jsc69/ComponentTester/doku/pcb.bmp

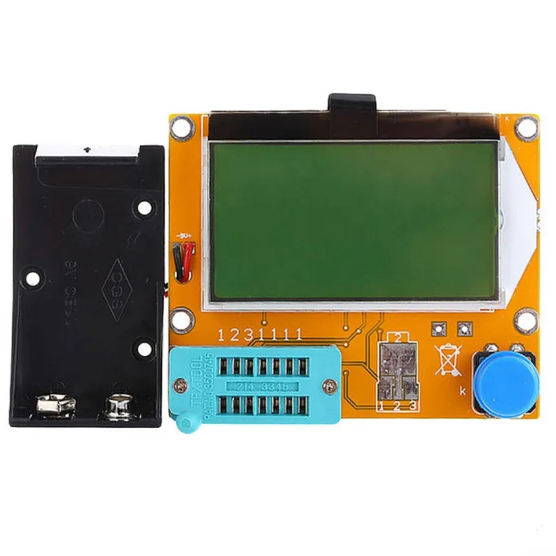
doku/pcb.bmp
