jsc69/ComponentTester/software/ArduTester/README.md

# Ardutester
ArduTester – Arduino Component Tester

This is an Arduino porting of the excellent work by Markus Frejek.</br>
The Ardutester software is based on porting by Markus Reschke (madires@theca-tabellaria.de)

The final aim is to create an economic component tester using Arduino and a few passive components; 
I’m trying to make the system more scalable as possible, so you can view the output in Serial Terminal or alternatively via a I2C LCD.</br>
I’m working on a shield which will also include the components for the Logic Analyzer (Another project of ABC). For my convenience i publish first SMD version and then TH Version.

This is the basic design:



## Fork
https://github.com/kr4fty/ArduProj
