jsc69/ComponentTester/software/brutzelboy_demo.gif

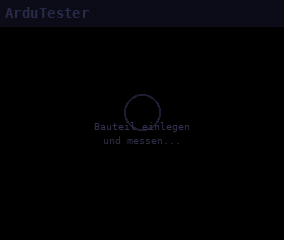
software/brutzelboy_demo.gif
