jsc69/ComponentTester/3d/stencil-ComponentTester.FCStd

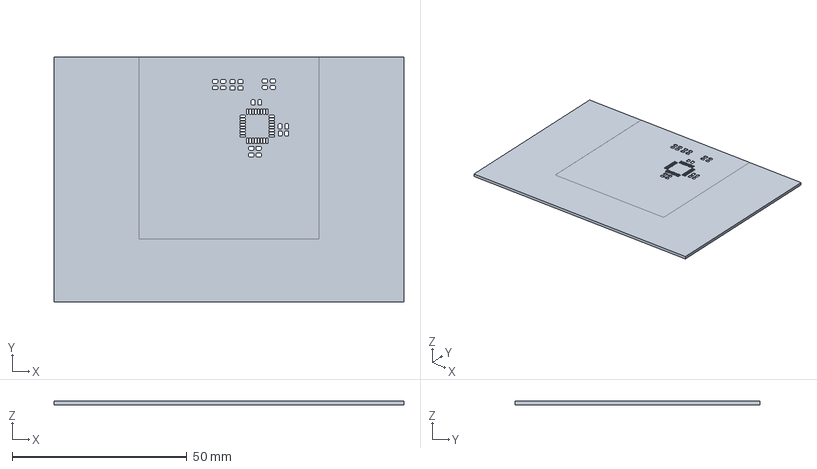
[picture p92: CAD file, 2025-10-31]
3d/stencil-ComponentTester.FCStd
100.0 x 70.0 x 1.05 mm
