jsc69/ComponentTester/3d/stencil.FCStd

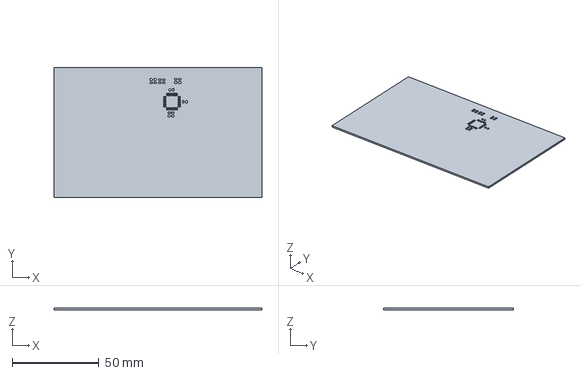
[picture p93: CAD file, 2025-10-31]
3d/stencil.FCStd
120.0 x 75.0 x 1.00 mm
