jsc69/ComponentTester/3d/cartridge.FCStd

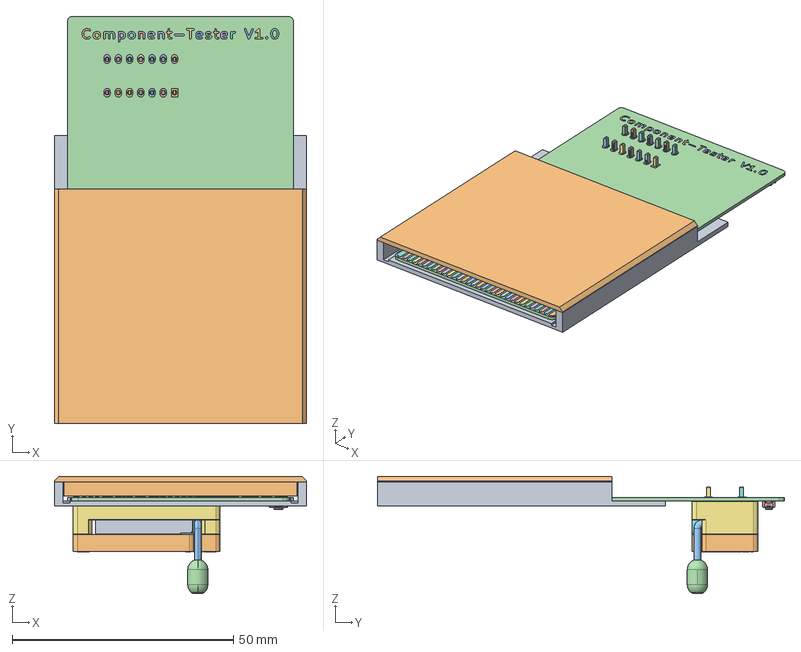
[picture p94: CAD file, 2025-10-31]
3d/cartridge.FCStd
57.0 x 91.9 x 26.4 mm
back001
front
R_0805_2012Metric
R_0805_2012Metric001
R_0805_2012Metric002
R_0805_2012Metric003
C_0805_2012Metric
TQFP-32_7x7mm_P0.8mm
R_0805_2012Metric004
R_0805_2012Metric005
R_0805_2012Metric006
C_0805_2012Metric001
C_0805_2012Metric002
C_0805_2012Metric003
01 Zif Socket Body_1
02 Zif Socket Body_2
02 Zif Socket Body_003
03 Zif Socket Body_3
04 Zif Socket Handle
04 Zif Socket Handle001
06 Zif Socket Screw
06 Zif Socket Screw001
05 Zif Socket Pin
05 Zif Socket Pin001
05 Zif Socket Pin002
05 Zif Socket Pin003
05 Zif Socket Pin004
05 Zif Socket Pin005
05 Zif Socket Pin006
05 Zif Socket Pin007
05 Zif Socket Pin008
05 Zif Socket Pin009
05 Zif Socket Pin010
05 Zif Socket Pin011
05 Zif Socket Pin012
05 Zif Socket Pin013
SW_Push_1P1T_NO_CK_KMR2
ComponentTester_pad
ComponentTester_pad001
ComponentTester_pad002
ComponentTester_pad003
ComponentTester_pad004
ComponentTester_pad005
ComponentTester_pad006
ComponentTester_pad007
ComponentTester_pad008
ComponentTester_pad009
ComponentTester_pad010
ComponentTester_pad011
ComponentTester_pad012
ComponentTester_pad013
ComponentTester_pad014
ComponentTester_pad015
ComponentTester_pad016
ComponentTester_pad017
ComponentTester_pad018
ComponentTester_pad019
ComponentTester_pad020
ComponentTester_pad021
ComponentTester_pad022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
