jsc69/ComponentTester/3d/stencil-CompomentTester.stl

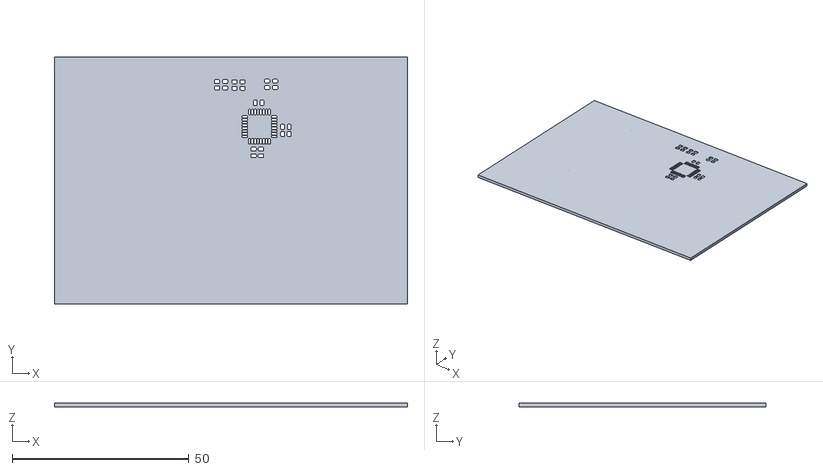
[picture p95: CAD file, 2025-10-31]
3d/stencil-CompomentTester.stl
100.0 x 70.0 x 1.05
