jsc69/ComponentTester/3d/cartridge-front.step

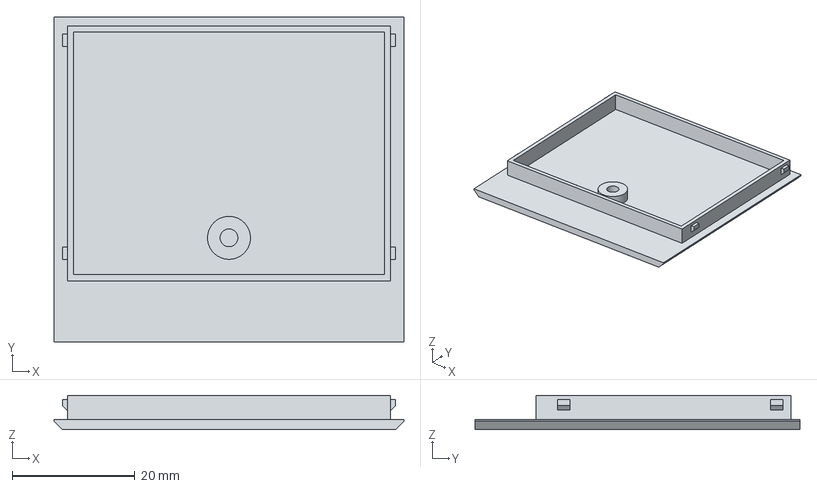
[picture p96: CAD file, 2025-09-19]
3d/cartridge-front.step
57.0 x 53.0 x 5.60 mm
