jsc69/ComponentTester/3d/cartridge-back.step

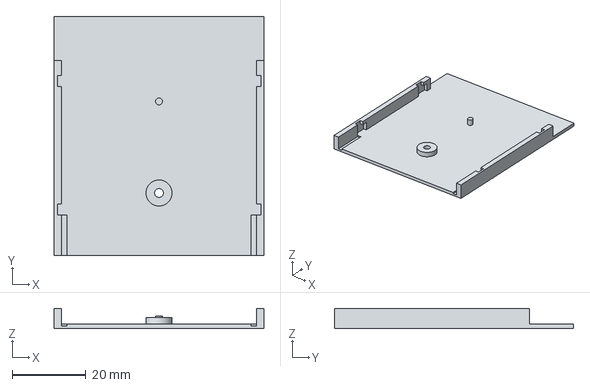
[picture p97: CAD file, 2025-09-19]
3d/cartridge-back.step
57.0 x 65.0 x 5.50 mm
