jsc69/ComponentTester/doku/tester_uno_tim1.bmp

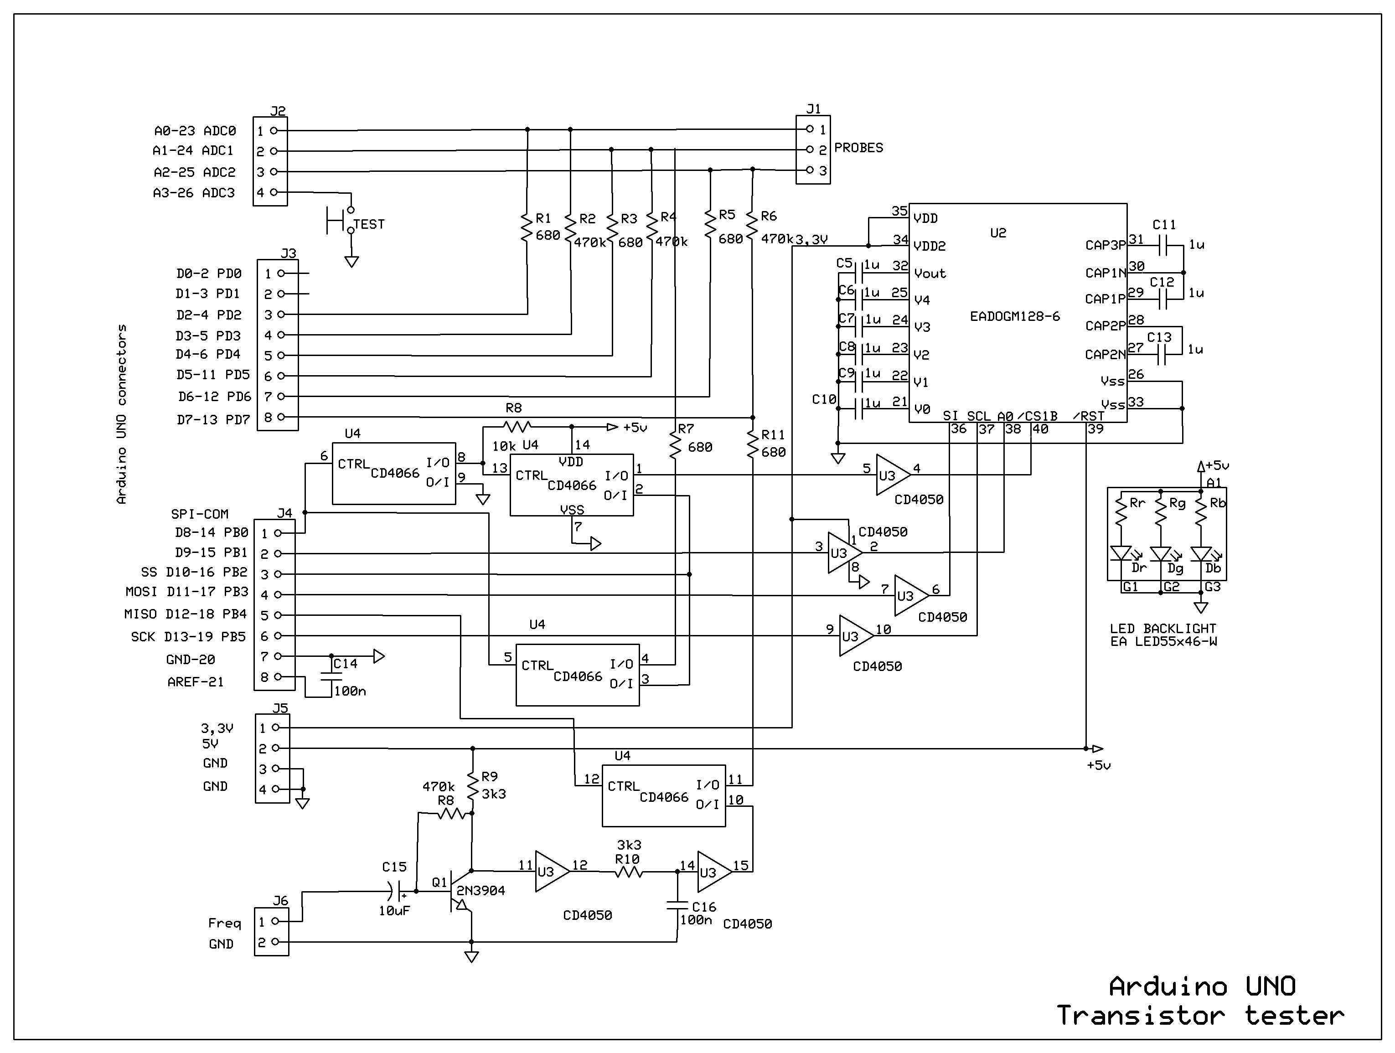
doku/tester_uno_tim1.bmp
