jsc69/ComponentTester/hardware/ComponentTester/ComponentTester.pdf

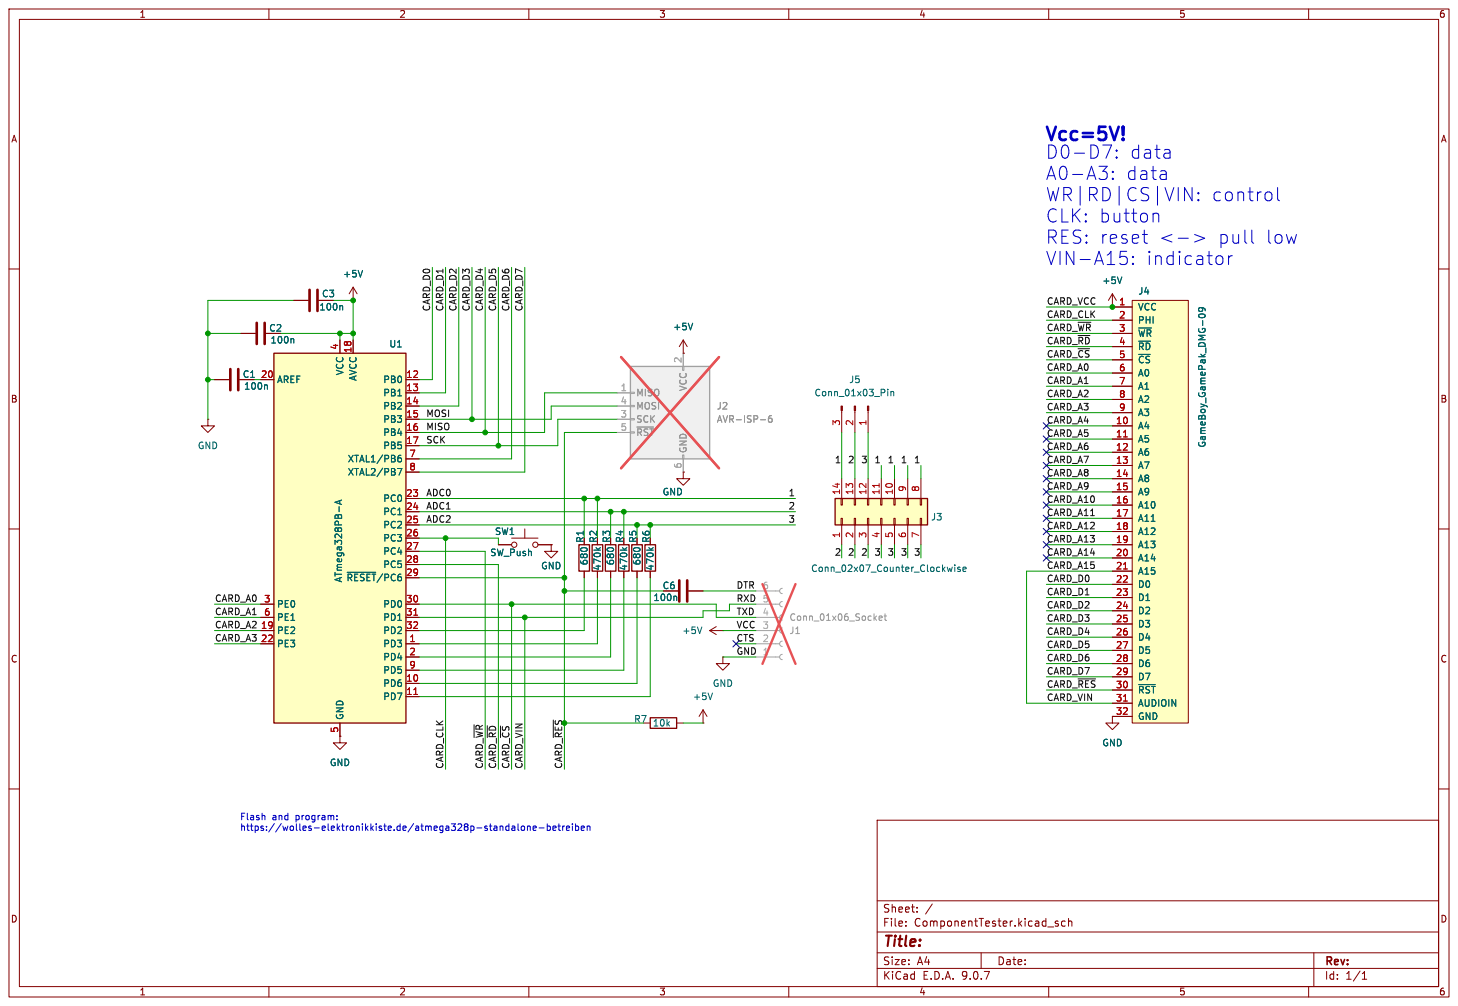
[picture p100: page 1]

6 MISO 1 MOSI 4 SCK 3 ~{RST} 5 +5V GND R3 680 R4 470k R2 470k R5 680 R1 680 R6 470k C6

6 MISO 1 MOSI 4 SCK 3 ~{RST} 5

Flash and program: https://wolles-elektronikkiste.de/atmega328p-standalone-betreiben GND
