jsc69/ComponentTester/doku/GBC_CARD.pdf

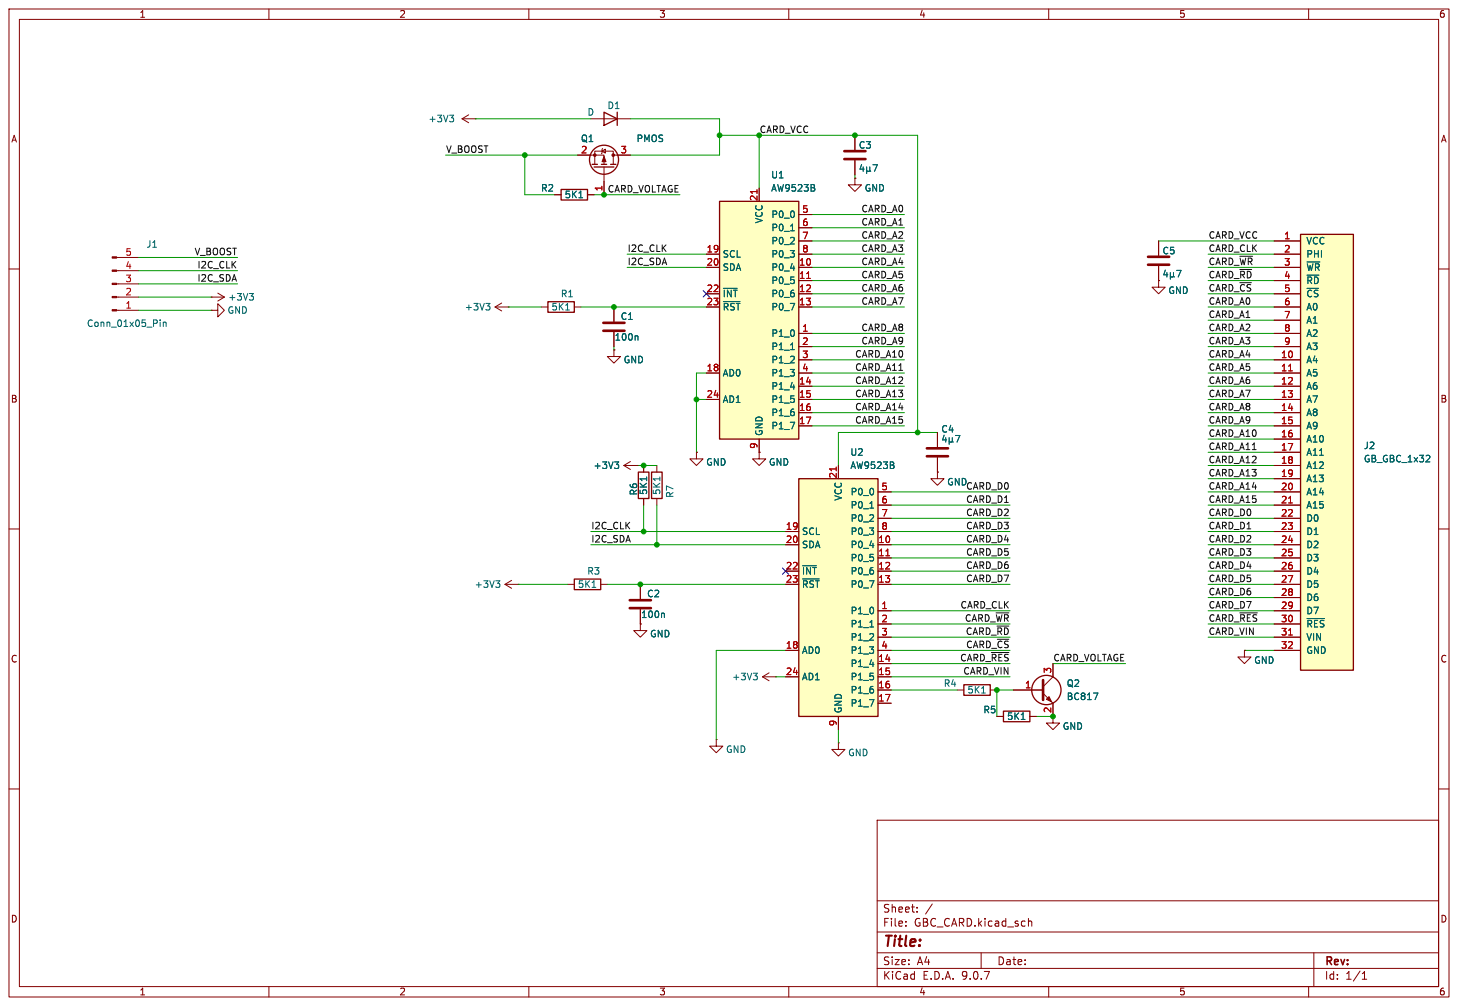
[picture p101: page 1]

Id: 1/1 Title: File: GBC_CARD.kicad_sch Sheet: /
