jsc69/ComponentTester/doku/Schematic_transistor+tester_2022-08-26.pdf

A | A

1

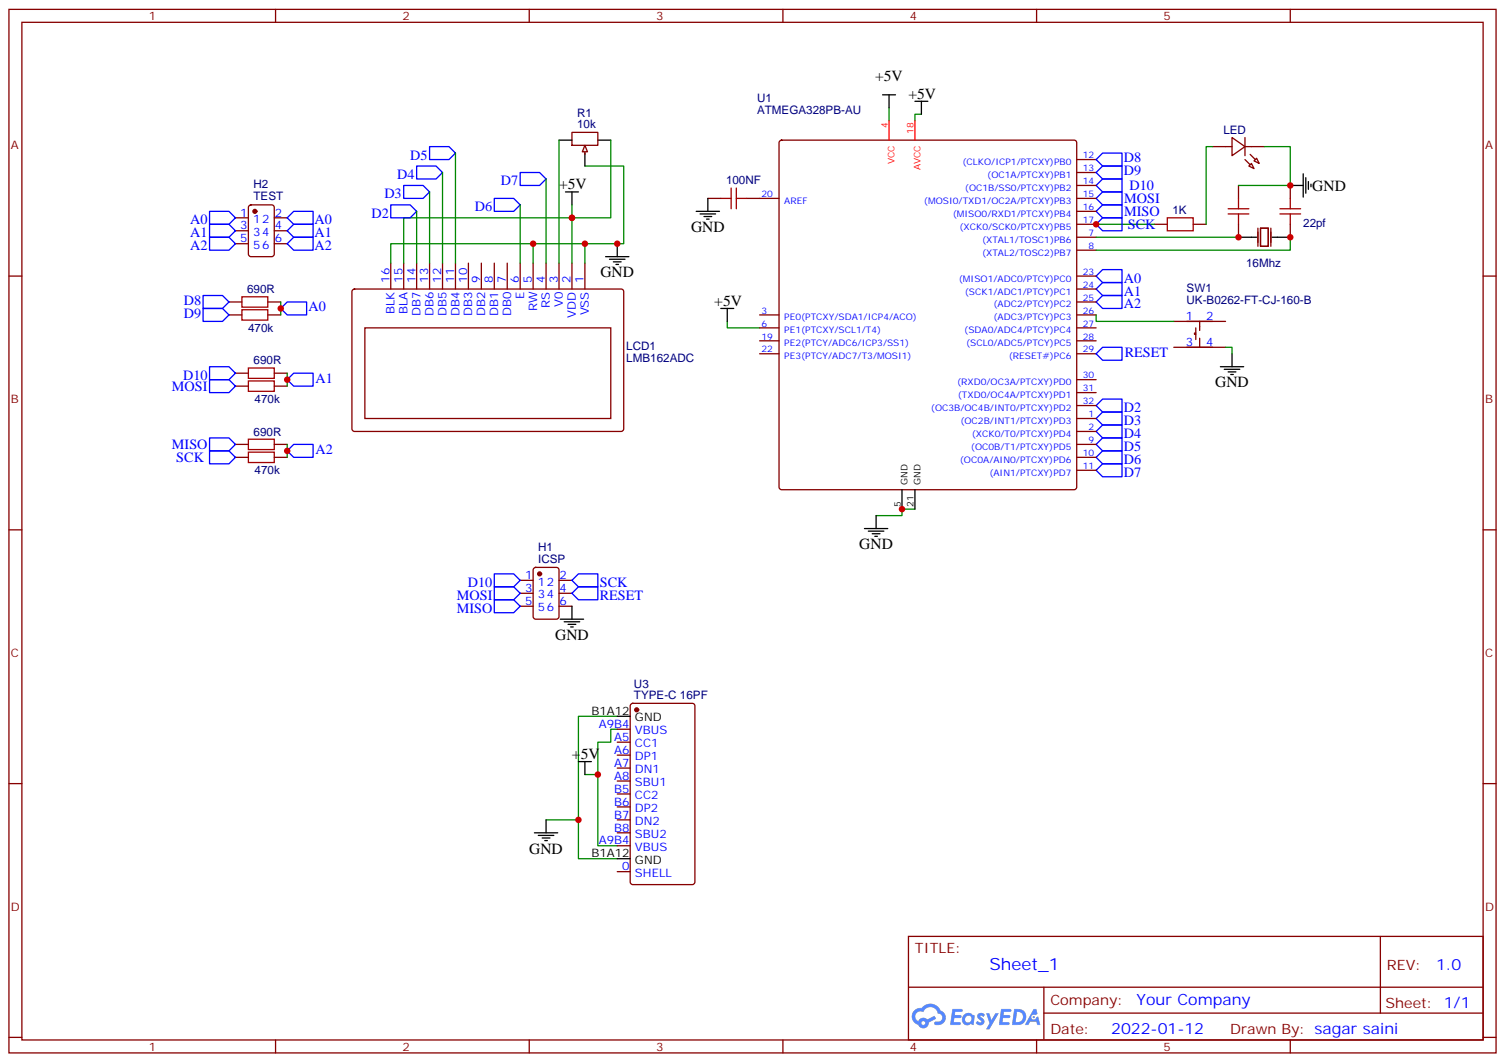
[picture p102: page 1]

Drawn By: sagar saini
