jsc69/ComponentTester/hardware/ComponentTester/ComponentTester.kicad_pcb

## KiCad design hardware/ComponentTester/ComponentTester.kicad_pcb (2026-03-12)

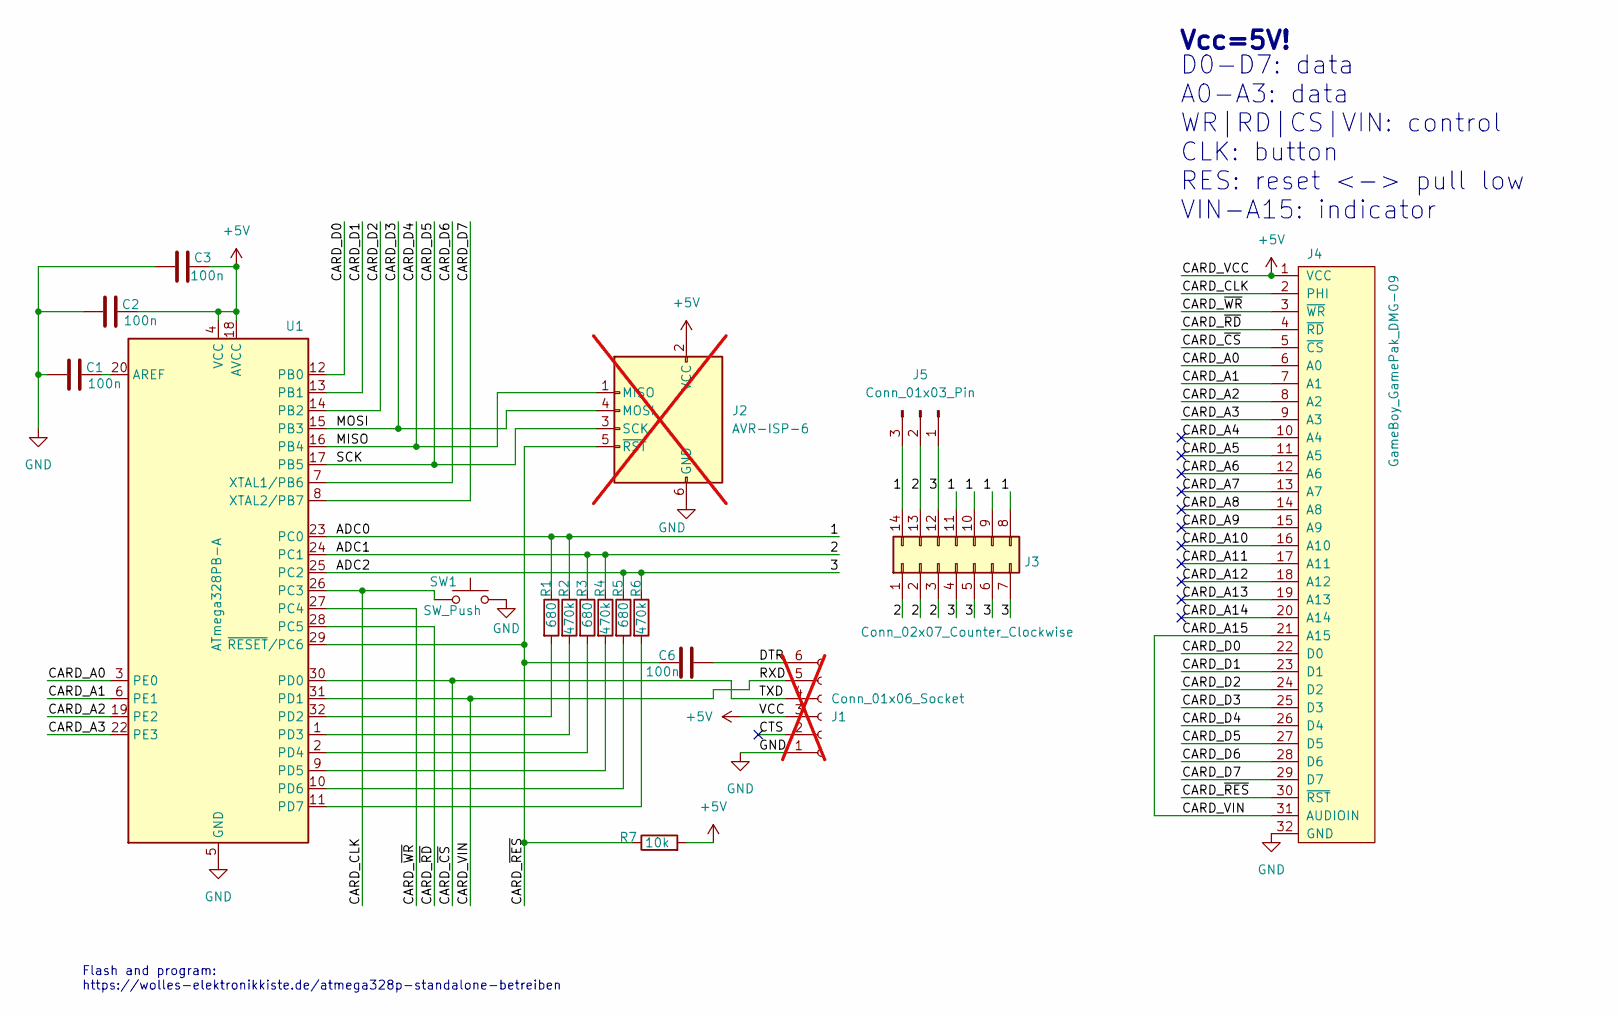
[picture p103: schematic ComponentTester.kicad_sch]

Parts:
C1, C2, C3, C6: 100n; C_0805_2012Metric
J1: Conn_01x06_Socket; PinHeader_1x06_P2.54mm_Vertical; not fitted
J2: AVR-ISP-6; PinHeader_2x03_P2.54mm_Vertical; not fitted
J3: Conn_02x07_Counter_Clockwise; DIP_Socket-14_W4.3mm_W5.08mm_W7.62mm_W10.16mm_W10.9mm_3M_21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
J4: GameBoy_GamePak_DMG-09; GameBoy_GamePak_DMG-09_P1.50mm_Edge
J5: Conn_01x03_Pin; Component_Testpad
R1, R3, R5: 680; R_0805_2012Metric
R2, R4, R6: 470k; R_0805_2012Metric
R7: 10k; R_0805_2012Metric
SW1: SW_Push; SW_Push_1P1T_NO_CK_KMR2
U1: ATmega328PB-A; TQFP-32_7x7mm_P0.8mm

Connections:
+5V: C2.1, C3.1, J1.3, J2.2 (VCC), J4.1 (VCC), R7.2, U1.4 (VCC), U1.18 (AVCC)
/1: J3.8, J3.9, J3.10, J3.11, J3.14, J5.3, R1.1, R2.1, U1.23 (PC0)
/2: J3.1, J3.2, J3.3, J3.13, J5.2, R3.1, R4.1, U1.24 (PC1)
/3: J3.4, J3.5, J3.6, J3.7, J3.12, J5.1, R5.1, R6.1, U1.25 (PC2)
/CARD_A0: J4.6 (A0), U1.3 (PE0)
/CARD_A1: J4.7 (A1), U1.6 (PE1)
/CARD_A2: J4.8 (A2), U1.19 (PE2)
/CARD_A3: J4.9 (A3), U1.22 (PE3)
/CARD_A4: J4.10 (A4)
/CARD_A5: J4.11 (A5)
/CARD_A6: J4.12 (A6)
/CARD_A7: J4.13 (A7)
/CARD_A8: J4.14 (A8)
/CARD_A9: J4.15 (A9)
/CARD_A10: J4.16 (A10)
/CARD_A11: J4.17 (A11)
/CARD_A12: J4.18 (A12)
/CARD_A13: J4.19 (A13)
/CARD_A14: J4.20 (A14)
/CARD_A15: J1.5, J4.21 (A15), J4.31 (AUDIOIN), U1.31 (PD1)
/CARD_CLK: J4.2 (PHI), SW1.1, U1.26 (PC3)
/CARD_D0: J4.22 (D0), U1.12 (PB0)
/CARD_D1: J4.23 (D1), U1.13 (PB1)
/CARD_D2: J4.24 (D2), U1.14 (PB2)
/CARD_D3: J2.4 (MOSI), J4.25 (D3), U1.15 (PB3)
/CARD_D4: J2.1 (MISO), J4.26 (D4), U1.16 (PB4)
/CARD_D5: J2.3 (SCK), J4.27 (D5), U1.17 (PB5)
/CARD_D6: J4.28 (D6), U1.7 (XTAL1/PB6)
/CARD_D7: J4.29 (D7), U1.8 (XTAL2/PB7)
/CARD_~CS: J1.4, J4.5 (~CS), U1.30 (PD0)
/CARD_~RD: J4.4 (~RD), U1.28 (PC5)
/CARD_~RES: C6.2, J2.5 (~RST), J4.30 (~RST), R7.1, U1.29 (~RESET/PC6)
/CARD_~WR: J4.3 (~WR), U1.27 (PC4)
/CTS: J1.2
/DTR: C6.1, J1.6
GND: C1.2, C2.2, C3.2, J1.1, J2.6 (GND), J4.32 (GND), SW1.2, U1.5 (GND), U1.21 (GND)
unnamed: C1.1, U1.20 (AREF)
unnamed: R1.2, U1.32 (PD2)
unnamed: R2.2, U1.1 (PD3)
unnamed: R3.2, U1.2 (PD4)
unnamed: R4.2, U1.9 (PD5)
unnamed: R5.2, U1.10 (PD6)
unnamed: R6.2, U1.11 (PD7)

Notes on the sheet:
Flash and program: https://wolles-elektronikkiste.de/atmega328p-standalone-betreiben
Vcc=5V!
D0-D7: data A0-A3: data WR|RD|CS|VIN: control CLK: button RES: reset <-> pull low VIN-A15: indicator

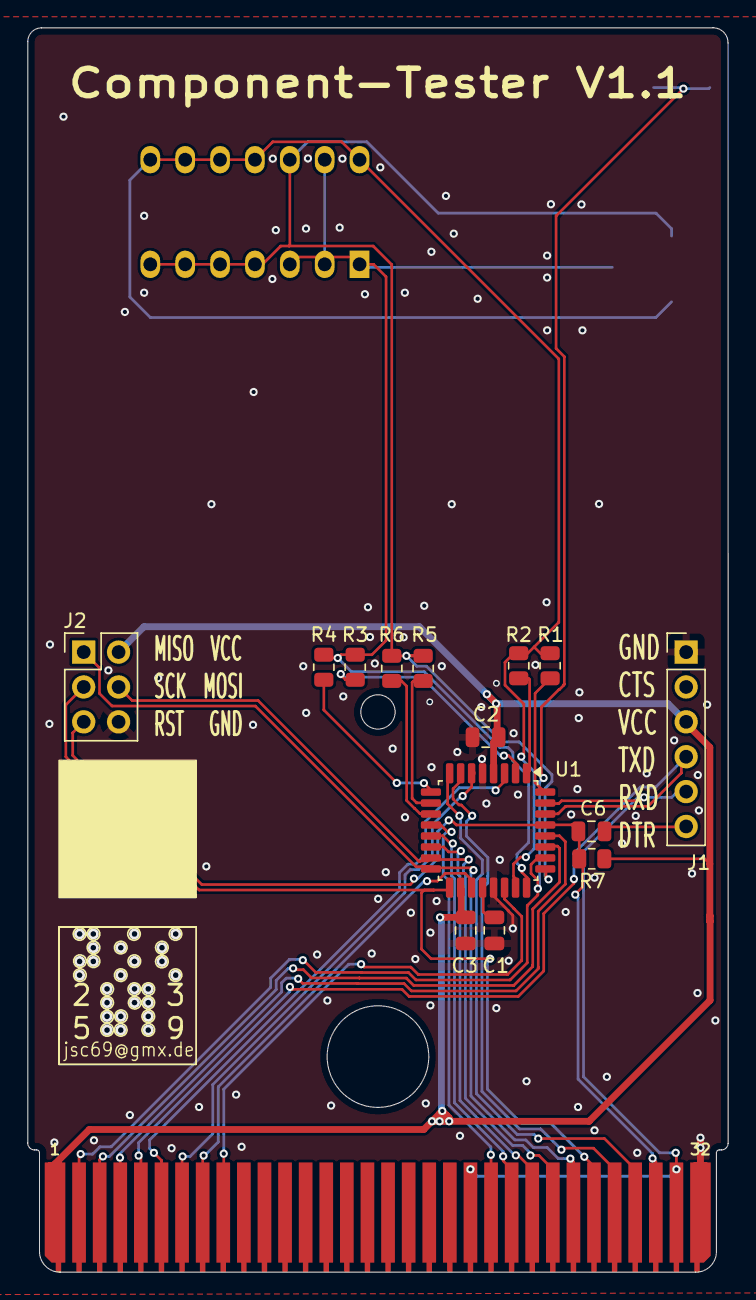
[picture p104: board ComponentTester.kicad_pcb from above]

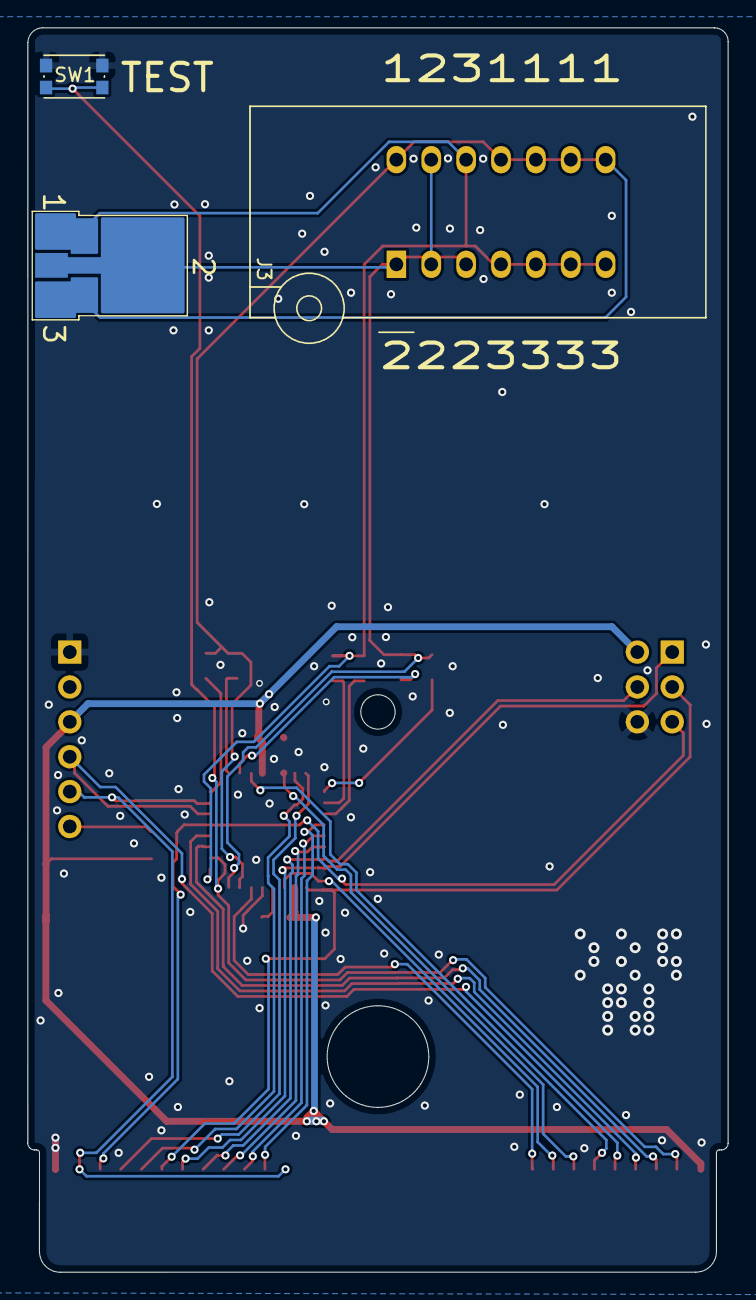
[picture p105: board ComponentTester.kicad_pcb from below]

Board: 2 copper layers, 51.0 x 90.6 mm, 18 parts (3 on the bottom side), 31 nets.
