jsc69/ComponentTester/software/ArduTester/ArduTester.ino

/*

      ___           ___          _____          ___                       ___           ___                       ___           ___     
     /  /\         /  /\        /  /::\        /__/\          ___        /  /\         /  /\          ___        /  /\         /  /\    
    /  /::\       /  /::\      /  /:/\:\       \  \:\        /  /\      /  /:/_       /  /:/_        /  /\      /  /:/_       /  /::\   
   /  /:/\:\     /  /:/\:\    /  /:/  \:\       \  \:\      /  /:/     /  /:/ /\     /  /:/ /\      /  /:/     /  /:/ /\     /  /:/\:\  
  /  /:/~/::\   /  /:/~/:/   /__/:/ \__\:|  ___  \  \:\    /  /:/     /  /:/ /:/_   /  /:/ /::\    /  /:/     /  /:/ /:/_   /  /:/~/:/  
 /__/:/ /:/\:\ /__/:/ /:/___ \  \:\ /  /:/ /__/\  \__\:\  /  /::\    /__/:/ /:/ /\ /__/:/ /:/\:\  /  /::\    /__/:/ /:/ /\ /__/:/ /:/___
 \  \:\/:/__\/ \  \:\/:::::/  \  \:\  /:/  \  \:\ /  /:/ /__/:/\:\   \  \:\/:/ /:/ \  \:\/:/~/:/ /__/:/\:\   \  \:\/:/ /:/ \  \:\/:::::/
  \  \::/       \  \::/~~~~    \  \:\/:/    \  \:\  /:/  \__\/  \:\   \  \::/ /:/   \  \::/ /:/  \__\/  \:\   \  \::/ /:/   \  \::/~~~~ 
   \  \:\        \  \:\         \  \::/      \  \:\/:/        \  \:\   \  \:\/:/     \__\/ /:/        \  \:\   \  \:\/:/     \  \:\     
    \  \:\        \  \:\         \__\/        \  \::/          \__\/    \  \::/        /__/:/          \__\/    \  \::/       \  \:\    
     \__\/         \__\/                       \__\/                     \__\/         \__\/                     \__\/         \__\/    
		



 ARDUTESTER v0.X 25/04/2013
 
 Original Source from:        http://www.mikrocontroller.net/articles/AVR-Transistortester
 Original Software:           by Karl-Heinz Kuebbeler (kh_kuebbeler@web.de)
                              The Ardutester software is based on porting by Markus Reschke (madires@theca-tabellaria.de) 
 
 Schematic & Home Page:       http://www.pighixxx.com/lavori/ardutester/ 
 
 Arduino version:             PighiXXX (info@pighixxx.com)
                              PaoloP (http://www.arduino.cc/forum/index.php?action=profile;u=58300)
 
 - ONLY TTL COMPONENTS!
 
 TODO:
 - Detailed Component Analysis
 
 CHANGELOG:
 - 01/05/2013 v06e - Waitus Function, String to Flash Functions, Killed 3 Goto :-), Code Cleanup - PighiXXX 
 - 01/05/2013 v06f - Killed all Goto (Thanks to PaoloP), Implemented Button
 - 01/05/2013 v06g - Code Cleanup
 - 02/05/2013 v06h - Code Cleanup, SERIAL-LCD Flag, I2C LCD Functions
 - 02/05/2013 v06i - Button Flag, Button Function
 - 02/05/2013 v06j - PowerSave Function, Code Cleanup, Flag only when more info
 - 02/05/2013 v06k - Some fix (By PaoloP)
 - 03/05/2013 v06l - Disabled digital input on analog pins (By PaoloP), Minor fixes
 - 04/05/2013 v06m - ShowFET() fixed, Code Cleanup, Short Circuit Ok
 - 05/05/2013 v06n - CheckResistor Function Ok
 - 06/05/2013 v06o - SelfTest Function (v0.3), SelfAdjust, Minor fixes
 - 21/05/2013 v06p - Add LCD no I2C, Removed Leonardo support: this sketch work only on ATmega328. (By PaoloP)
 - 07/06/2013 v06q - ArduTester Software Client Functions (By PighiXXX)
 - 08/07/2013 v07a - SmallResistor() fixes, Inductance Measurement, Leakage Current Measurement, BJT functions fixed, Minor fixes (By PighiXXX)
                     TODO ReCheck Print Functions & LCD Functions - This is an alpha version! Lightless version!
 - 17/07/2013 v07b - MOSFETs function fixed, Minor fixes, Show Functions revisited, I2C LCD Deprecated, Deep debug :-)
                     Button Function revisited, PWM Tool, Serial Menu, AutoAdjust, EEProm functions (By PighiXXX)
 - 21/07/2013 v07c   Some fix (By PaoloP), LCD Functions revisited (By PighiXXX) 
 - 22/07/2013 v07d   LCDMenu, Some fix (By PighiXXX)
 - 23/07/2013 v07e   SetDefault function, Some fix, selFreq optimized, TestKey improvements, Client support (By PighiXXX)
                     TWI, SPI, TIMER2 disabled (By PaoloP)
 - 25/07/2013 v07f   ReadU function revisited (By PaoloP), Some fix (By PaoloP & PighiXXX)

*/

//WorkAround for IDE ifndef bug
char foo; 

                                                 //ARDUTESTER FEATURES
// ================================================================
// ArduTester fuer BrutzelBoy ESP32-Cartridge-Schnittstelle
// ATmega328P oder ATmega328PB erforderlich
// ================================================================
#define DEBUG_PRINT                              //Serial-Ausgabe aktivieren
#define USER_WAIT             3000               //Nextpage Timeout

//Check MCU
#if not defined(__AVR_ATmega328P__) && not defined(__AVR_ATmega328PB__)
  #error Benoetigt ATmega328P oder ATmega328PB
#endif

//Includes
#include <avr/wdt.h>
#include <avr/sleep.h>
#include <avr/power.h>
#include <EEPROM.h>

//LCD Output

//UINT32_MAX
#define UINT32_MAX            ((uint32_t)-1)

//Test probes - Must be an ADC port :-)
#define ADC_PORT              PORTC              //ADC port data register 
#define ADC_DDR               DDRC               //ADC port data direction register 
#define ADC_PIN               PINC               //Port input pins register 
#define TP1                   0                  //Test pin 1 (=0) 
#define TP2                   1                  //Test pin 2 (=1) 
#define TP3                   2                  //Test pin 3 (=2) 
/*
   Probe resistors: 
   The resistors must be connected to the lower 6 pins of the port in
   following sequence:
    - pin 0: Rl1 680R (test pin 1)
    - pin 1: Rh1 470k (test pin 1)
    - pin 2: Rl2 680R (test pin 2)
    - pin 3: Rh2 470k (test pin 2)
    - pin 4: Rl3 680R (test pin 3)
    - pin 5: Rh3 470k (test pin 3)
*/
  // ATmega328PB-Platine: Widerstände an PORTD (PD2-PD7) statt PORTB
  // Original-Hardware (Arduino Uno): PORTB
  #define R_PORT                PORTD            //Port data register
  #define R_DDR                 DDRD             //Port data direction register

//Push button

//Button Delay
#define CYCLE_DELAY           3000

                                                 //ARDUESTER PARAMETERS

//Maximum number of measurements without any components found.
#define CYCLE_MAX             5
//ADC voltage reference based on Vcc (in mV). 
#define UREF_VCC              3300
/*
  Offset for the internal bandgap voltage reference (in mV): -100 up to 100
   - To compensate any difference between real value and measured value.
   - The ADC has a resolution of about 4.88mV for V_ref = 5V (Vcc) and
     1.07mV for V_ref = 1.1V (bandgap).
   - Will be added to measured voltage of bandgap reference.
*/
#define UREF_OFFSET           0
/*
   Exact values of probe resistors.
    - Standard value for Rl is 680 Ohms.
    - Standard value for Rh is 470k Ohms.
*/
//Rl in Ohms
#define R_LOW                 680
//Rh in Ohms
#define R_HIGH                470000
//Offset for systematic error of resistor measurement with Rh (470k) in Ohms.
#define RH_OFFSET             700 
/*
   Resistance of probe leads (in 0.01 Ohms).
    - Resistance of two probe leads in series.
    - Assuming all probe leads got same/similar resistance.
*/
#define R_ZERO                20
/* 
   Capacitance of the wires between PCB and terminals (in pF).
   Examples:
    - 2pF for wires 10cm long
*/
#define CAP_WIRES             15
/* 
   Capacitance of the probe leads connected to the tester (in pF).
   Examples:
     capacity  length of probe leads
     -------------------------------
      3pF      about 10cm
      9pF      about 30cm
     15pF      about 50cm
*/
#define CAP_PROBELEADS        9
//Maximum voltage at which we consider a capacitor being discharged (in mV)
#define CAP_DISCHARGED        2
/*
   Number of ADC samples to perform for each mesurement.
    - Valid values are in the range of 1 - 255.
*/
#define ADC_SAMPLES           25
//Estimated internal resistance of port to GND (in 0.1 Ohms)
#define R_MCU_LOW             200                //Default: 209
//Estimated internal resistance of port to VCC (in 0.1 Ohms)
#define R_MCU_HIGH            220                //Default: 235
//Voltage offset of ÂµCs analog comparator (in mV): -50 up to 50
#define COMPARATOR_OFFSET     15
//Capacitance of the probe tracks of the PCB and the ÂµC (in pF)
#define CAP_PCB               42
//Total default capacitance (in pF): max. 255
#define C_ZERO                CAP_PCB + CAP_WIRES + CAP_PROBELEADS
//ATMEGA328, 16Mhz Related
#define ADC_CLOCK_DIV         (1 << ADPS2) | (1 << ADPS1) | (1 << ADPS0)
#define CPU_FREQ              F_CPU
#define OSC_STARTUP           16384

//Components ID's
#define COMP_NONE             0
#define COMP_ERROR            1
#define COMP_MENU             2
#define COMP_RESISTOR         10
#define COMP_CAPACITOR        11
#define COMP_INDUCTOR         12
#define COMP_DIODE            20
#define COMP_BJT              21
#define COMP_FET              22
#define COMP_IGBT             23
#define COMP_TRIAC            24
#define COMP_THYRISTOR        25

//Chars
#define LCD_CHAR_UNSET        0                  //Just a place holder 
#define LCD_CHAR_DIODE1       1                  //Diode icon '>|' 
#define LCD_CHAR_DIODE2       2                  //Diode icon '|<' 
#define LCD_CHAR_CAP          3                  //Capacitor icon '||' 
#define LCD_CHAR_FLAG         4                  //Flag Icon
#define LCD_CHAR_RESIS1       6                  //Resistor left icon '[' 
#define LCD_CHAR_RESIS2       7                  //Resistor right icon ']'
  #define LCD_CHAR_OMEGA      79              
  #define LCD_CHAR_MICRO      '\u00B5'           //Code for Arduino Serial Monitor

//Error type IDs
#define TYPE_DISCHARGE        1                  //Discharge error

//FET type bit masks (also used for IGBTs)
#define TYPE_N_CHANNEL        0b00000001         //n channel 
#define TYPE_P_CHANNEL        0b00000010         //p channel 
#define TYPE_ENHANCEMENT      0b00000100         //Enhancement mode 
#define TYPE_DEPLETION        0b00001000         //Depletion mode 
#define TYPE_MOSFET           0b00010000         //MOSFET 
#define TYPE_JFET             0b00100000         //JFET 
#define TYPE_IGBT             0b01000000         //IGBT (no FET) 

//Mode bitmask
#define MODE_LOW_CURRENT      0b00000001         //Low test current 
#define MODE_HIGH_CURRENT     0b00000010         //High test current 
#define MODE_DELAYED_START    0b00000100         //Delayed start

//BJT (bipolar junction transistor) type IDs 
#define TYPE_NPN              1                  //NPN
#define TYPE_PNP              2                  //PNP

//Tester operation modes
#define MODE_CONTINOUS        0                  //Continous
#define MODE_AUTOHOLD         1                  //Auto hold 

//Multiplicator tables
#define TABLE_SMALL_CAP       1
#define TABLE_LARGE_CAP       2
#define TABLE_INDUCTOR        3

//Bit flags for PullProbe()
#define FLAG_PULLDOWN         0b00000000
#define FLAG_PULLUP           0b00000001
#define FLAG_1MS              0b00001000
#define FLAG_10MS             0b00010000

//Tester modes, offsets and values
typedef struct
{
  byte                        TesterMode;        //Tester operation mode
  byte                        SleepMode;         //MCU sleep mode 
  byte                        Samples;           //Number of ADC samples 
  byte                        AutoScale;         //Flag to disable/enable ADC auto scaling 
  byte                        RefFlag;           //Internal control flag for ADC 
  unsigned int                U_Bandgap;         //Voltage of internal bandgap reference (mV) 
  unsigned int                RiL;               //Internal pin resistance of ÂµC in low mode (0.1 Ohms) 
  unsigned int                RiH;               //Internal pin resistance of ÂµC in high mode (0.1 Ohms) 
  unsigned int                RZero;             //Resistance of probe leads (2 in series) (0.01 Ohms) 
  byte                        CapZero;           //Capacity zero offset (input + leads) (pF) 
  signed char                 RefOffset;         //Voltage offset of bandgap reference (mV) 
  signed char                 CompOffset;        //Voltage offset of analog comparator (mV) 
} Config_Type;

//Probes
typedef struct
{
  //Probe pins
  byte                        Pin_1;             //Probe-1
  byte                        Pin_2;             //Probe-2
  byte                        Pin_3;             //Probe-3 
  //Bit masks for switching probes and test resistors
  byte                        Rl_1;              //Rl mask for probe-1 
  byte                        Rh_1;              //Rh mask for probe-1 
  byte                        Rl_2;              //Rl mask for probe-2 
  byte                        Rh_2;              //Rh mask for probe-2 
  byte                        Rl_3;              //Rl mask for probe-3 
  byte                        Rh_3;              //Rh mask for probe-3 
  byte                        ADC_1;             //ADC mask for probe-1 
  byte                        ADC_2;             //ADC mask for probe-2 
} Probe_Type;

//Checking/probing
typedef struct
{
  byte                        Done;              //Flag for transistor detection done 
  byte                        Found;             //Component type which was found 
  byte                        Type;              //Component specific subtype 
  byte                        Resistors;         //Number of resistors found 
  byte                        Diodes;            //Number of diodes found 
  byte                        Probe;             //Error: probe pin 
  unsigned int                U;                 //Error: voltage left in mV 
} Check_Type;

//Resistor
typedef struct
{
  byte                        A;                 //Probe pin #1 
  byte                        B;                 //Probe pin #2 
  byte                        Scale;             //Exponent of factor (value * 10^x) 
  unsigned long               Value;             //Resistance 
} Resistor_Type;

//Capacitor
typedef struct
{
  byte                        A;                 //Probe pin #1 
  byte                        B;                 //Probe pin #2 
  signed char                 Scale;             //Exponent of factor (value * 10^x) 
  unsigned long               Value;             //Capacitance incl. zero offset 
  unsigned long               Raw;               //Capacitance excl. zero offset 
} Capacitor_Type;

//Inductor
typedef struct
{
  signed char                 Scale;             //Exponent of factor (value * 10^x) 
  unsigned long               Value;             //Inductance 
} Inductor_Type;

//Diode
typedef struct
{
  byte                        A;                 //Probe pin connected to anode 
  byte                        C;                 //Probe pin connected to cathode 
  unsigned int                V_f;               //Forward voltage in mV (high current) 
  unsigned int                V_f2;              //Forward voltage in mV (low current) 
} Diode_Type;

//Bipolar junction transistor
typedef struct
{
  byte                        B;                 //Probe pin connected to base 
  byte                        C;                 //Probe pin connected to collector 
  byte                        E;                 //Probe pin connected to emitter 
  unsigned long               hFE;               //Current amplification factor 
  //U_BE voltage
  unsigned int                I_CE0;             //Leakage current (in ÂµA) 
} BJT_Type;

//FET
typedef struct
{
  byte                        G;                 //Test pin connected to gate 
  byte                        D;                 //Test pin connected to drain 
  byte                        S;                 //Test pin connected to source 
  unsigned int                V_th;              //Threshold voltage of gate in mV 
} FET_Type;

//Error (failed discharge) - Deprecated
typedef struct
{

} Error_Type;

//Output buffers 
char                          OutBuffer[12];
char                          PRGBuffer[32]; 

//Configuration
Config_Type                   Config;            //Tester modes, offsets and values 

//Probing
Probe_Type                    Probes;            //Test probes 
Check_Type                    Check;             //Checking/testing 

//Components
Resistor_Type                 Resistors[3];      //Resistors (3 combinations) 
Capacitor_Type                Caps[3];           //Capacitors (3 combinations) 
Diode_Type                    Diodes[6];         //Diodes (3 combinations in 2 directions) 
BJT_Type                      BJT;               //Bipolar junction transistor 
FET_Type                      FET;               //FET 
Inductor_Type                 Inductor;          //Inductor

//Store String to Flash Functions :-)
class __FlashStringHelper;
#define X(str) (strcpy_P(PRGBuffer, PSTR(str)), PRGBuffer)

//Strings
const unsigned char Mode_str[] PROGMEM = "Mode:";
const unsigned char Continous_str[] PROGMEM = "Continous";
const unsigned char AutoHold_str[] PROGMEM = "Auto Hold";
const unsigned char Running_str[] PROGMEM = "Probing...";
const unsigned char Weak_str[] PROGMEM = "weak";
const unsigned char Low_str[] PROGMEM = "low";
const unsigned char Failed1_str[] PROGMEM = "No component";
const unsigned char Failed2_str[] PROGMEM = "found!";
const unsigned char Thyristor_str[] PROGMEM = "SCR";
const unsigned char Triac_str[] PROGMEM = "Triac";
const unsigned char GAK_str[] PROGMEM = "GAC=";
const unsigned char Done_str[] PROGMEM = "done!";
const unsigned char Select_str[] PROGMEM = "Select";
const unsigned char Selftest_str[] PROGMEM = "Selftest";
const unsigned char Adjustment_str[] PROGMEM = "Adjustment";
const unsigned char Default_str[] PROGMEM = "Default Values";
const unsigned char Save_str[] PROGMEM = "Save";
const unsigned char Show_str[] PROGMEM = "Show Values";
const unsigned char Remove_str[] PROGMEM = "Remove";
const unsigned char Create_str[] PROGMEM = "Create";
const unsigned char ShortCircuit_str[] PROGMEM = "Short Circuit!";
const unsigned char DischargeFailed_str[] PROGMEM = "Battery?";
const unsigned char Error_str[] PROGMEM = "Error!";
const unsigned char Battery_str[] PROGMEM = "Bat.";
const unsigned char OK_str[] PROGMEM = "ok";
const unsigned char MOS_str[] PROGMEM = "MOS";
const unsigned char FET_str[] PROGMEM = "FET";
const unsigned char Channel_str[] PROGMEM = "-ch";
const unsigned char Enhancement_str[] PROGMEM = "enh.";
const unsigned char Depletion_str[] PROGMEM = "dep.";
const unsigned char IGBT_str[] PROGMEM = "IGBT";
const unsigned char GateCap_str[] PROGMEM = "Cgs=";
const unsigned char GDS_str[] PROGMEM = "GDS=";
const unsigned char GCE_str[] PROGMEM = "GCE=";
const unsigned char NPN_str[] PROGMEM = "NPN";
const unsigned char PNP_str[] PROGMEM = "PNP";
const unsigned char EBC_str[] PROGMEM = "EBC=";
const unsigned char hFE_str[] PROGMEM ="h_FE=";
const unsigned char V_BE_str[] PROGMEM ="V_BE=";
const unsigned char I_CEO_str[] PROGMEM = "I_CEO=";
const unsigned char Vf_str[] PROGMEM = "Vf=";
const unsigned char DiodeCap_str[] PROGMEM = "C=";
const unsigned char Vth_str[] PROGMEM = "Vth=";
const unsigned char I_R_str[] PROGMEM = "I_R=";
const unsigned char URef_str[] PROGMEM = "Vref";
const unsigned char RhLow_str[] PROGMEM = "Rh-";
const unsigned char RhHigh_str[] PROGMEM = "Rh+";
const unsigned char RiLow_str[] PROGMEM = "Ri-";
const unsigned char RiHigh_str[] PROGMEM = "Ri+";
const unsigned char Rl_str[] PROGMEM = "+Rl-";
const unsigned char Rh_str[] PROGMEM = "+Rh-";
const unsigned char ProbeComb_str[] PROGMEM = "12 13 23";
const unsigned char CapOffset_str[] PROGMEM = "C0";
const unsigned char ROffset_str[] PROGMEM = "R0";
const unsigned char CompOffset_str[] PROGMEM = "AComp";
const unsigned char PWM_str[] PROGMEM = "PWM";
const unsigned char Hertz_str[] PROGMEM = "Hz";
const unsigned char Splash_str[] PROGMEM = "Ardutester ";
const unsigned char Version_str[] PROGMEM = "v0.7f";

  const unsigned char Cap_str[] PROGMEM = {'-','|','|', '-',0};
  const unsigned char Diode_AC_str[] PROGMEM = {'-', '>', '-', 0};
  const unsigned char Diode_CA_str[] PROGMEM = {'-', '<', '-', 0};
  const unsigned char Diodes_str[] PROGMEM = {'*', '>', ' ', ' ', 0};
  const unsigned char Resistor_str[] PROGMEM = {'-', '[', ']', '-', 0};

//Diode icon with anode at left side
byte DiodeIcon1[8]  = {0x11, 0x19, 0x1d, 0x1f, 0x1d, 0x19, 0x11, 0x00};
//Diode icon with anode at right side
byte DiodeIcon2[8]  = {0x11, 0x13, 0x17, 0x1f, 0x17, 0x13, 0x11, 0x00};
//Capacitor icon
byte CapIcon[8]  = {0x1b, 0x1b, 0x1b, 0x1b, 0x1b, 0x1b, 0x1b, 0x00};
//Resistor icon #1 (left part)
byte ResIcon1[8]  = {0x00, 0x0f, 0x08, 0x18, 0x08, 0x0f, 0x00, 0x00};
//Resistor icon #2 (right part)
byte ResIcon2[8]  = {0x00, 0x1e, 0x02, 0x03, 0x02, 0x1e, 0x00, 0x00};
//Flag Icon
byte FlagIcon[8] = {0x1f, 0x11, 0x0e, 0x04, 0x0a, 0x15, 0x1f, 0x00};

//Prefix Table
const unsigned char Prefix_table[]  = {'p', 'n', LCD_CHAR_MICRO, 'm', 0, 'k', 'M'};
//PWM menu: frequencies
const unsigned int PWM_Freq_table[]  = {100, 250, 500, 1000, 2500, 5000, 10000, 25000};
//Voltage based factors for large caps (using Rl)
const unsigned int LargeCap_table[]  = {23022, 21195, 19629, 18272, 17084, 16036, 15104, 14271, 13520, 12841, 12224, 11660, 11143, 10668, 10229, 9822, 9445, 9093, 8765, 8458, 8170, 7900, 7645, 7405, 7178, 6963, 6760, 6567, 6384, 6209, 6043, 5885, 5733, 5589, 5450, 5318, 5191, 5069, 4952, 4839, 4731, 4627, 4526, 4430, 4336};
//Voltage based factors for small caps (using Rh)
const unsigned int SmallCap_table[]  = {954, 903, 856, 814, 775, 740, 707, 676, 648};
//Ratio based factors for inductors
const unsigned int Inductor_table[]  = {4481, 3923, 3476, 3110, 2804, 2544, 2321, 2128, 1958, 1807, 1673, 1552, 1443, 1343, 1252, 1169, 1091, 1020, 953, 890, 831, 775, 721, 670, 621, 574, 527, 481, 434, 386, 334, 271};

//Bitmasks for Rl probe resistors based on probe ID
  // ATmega328PB-Platine: Rl an PD2/PD4/PD6, Rh an PD3/PD5/PD7
  // (Original Arduino Uno: Rl an PB0/PB2/PB4, Rh an PB1/PB3/PB5)
  const unsigned char Rl_table[] = {(1 << 2), (1 << 4), (1 << 6)};  // PD2, PD4, PD6
  #define RL_MASK(tp)  (Rl_table[tp])
  #define RH_MASK(tp)  (Rl_table[tp] << 1)

  // Bus-Defines für ESP32-Schnittstelle
  #define BUS_ID_DDR    DDRE    // PE0-PE3 fuer ID (CARD_A0-A3)
  #define BUS_ID_PORT   PORTE
  #define BUS_DATA_DDR  DDRB    // PB0-PB7 fuer Daten (CARD_D0-D7)
  #define BUS_DATA_PORT PORTB

  uint8_t ValueCounter = 0;    // Zaehler fuer VAL1..VAL4 in DisplayValue()
//Bitmasks for ADC pins based on probe ID
const unsigned char ADC_table[]  = {(1 << TP1), (1 << TP2), (1 << TP3)};

//Function prototype
byte SmallCap(Capacitor_Type *Cap);
byte LargeCap(Capacitor_Type *Cap);
byte MeasureInductor(Resistor_Type *Resistor);
void ShowDiode_Uf(Diode_Type *Diode);
void ShowDiode_C(Diode_Type *Diode);

// ================================================================
// FOR_BRUTZELBOY: Bus-Kommunikation und Kommandoempfang
//
// Nur 2 Steuerpins — CS (PD0) wird nicht verwendet:
//   PC4 (CARD_WR) — ATmega → ESP32: Frame-Strobe / Bereit-ACK
//   PC5 (CARD_RD) — ESP32  → ATmega: Frame-ACK / Kommando-Trigger
//
// ATmega sendet Frame:
//   ① ID + Data auf PE0-3 / PB0-7 anlegen
//   ② WR = HIGH  ("Frame liegt an")
//   ③ warten auf RD = HIGH vom ESP32 (ACK, max. BB_ACK_TIMEOUT_US)
//   ④ WR = LOW   ("Übertragung fertig")
//   ⑤ warten auf RD = LOW (ESP32 bestätigt Ende, Timeout ignorieren)
//   ⑥ Bus freigeben
//
// ESP32 sendet Kommando:
//   ① ESP32 setzt RD = HIGH ("Kommando pending")
//   ② ATmega-loop erkennt RD = HIGH → checkBrutzelBoyCommand()
//   ③ ATmega schaltet Bus als Eingang, setzt WR = HIGH ("bereit")
//   ④ ESP32 sieht WR = HIGH → legt cmd + param auf Bus
//   ⑤ ATmega liest PINE & PINB, setzt WR = LOW ("gelesen")
//   ⑥ ESP32 sieht WR = LOW → setzt RD = LOW, gibt Bus frei
//
// Kommando-Tabelle (PE0-PE3):
//   0x0  NOP          - nichts tun
//   0x1  START_TEST   - neuen Bauteiltest starten
//   0x2  FREQ_METER   - Frequenzmessung (STUB)
//   0x3  SIG_GEN      - Signalgenerator, Param = Frequenz-Index
//   0x4  PWM_GEN      - PWM-Generator, Param = Duty-Cycle % (1-99, 0=STOPP)
//   0x5  C_ESR_METER  - Kondensator+ESR-Messung (STUB)
//   0x6  SELF_TEST    - Kalibrierung / Selbsttest
//   0x7  POWER_OFF    - ArduTester ausschalten (Standby)
//   0x8-0xF  reserviert
// ================================================================

// Handshake-Pin-Defines
#define BB_HANDSHAKE_PIN   PINC
#define BB_HANDSHAKE_DDR   DDRC
#define BB_HANDSHAKE_PORT  PORTC
#define BB_WR_BIT   PC4    // ATmega → ESP32: Frame-Strobe / Bereit-ACK
#define BB_RD_BIT   PC5    // ESP32  → ATmega: Frame-ACK / Kommando-Trigger

#define BB_BTN_PIN  PINC
#define BB_BTN_DDR  DDRC
#define BB_BTN_BIT  PC3    // Taster: GND = gedrückt (low-active)

// PORTC-Bits die nie durch ADC_DDR/ADC_PORT-Zuweisungen überschrieben werden dürfen
#define BB_PORTC_PRESERVE  ((1<<BB_WR_BIT)|(1<<BB_RD_BIT)|(1<<BB_BTN_BIT))  // 0x38
#define SET_ADC_DDR(x)   (ADC_DDR  = ((ADC_DDR  & BB_PORTC_PRESERVE) | ((x) & ~BB_PORTC_PRESERVE)))
#define SET_ADC_PORT(x)  (ADC_PORT = ((ADC_PORT & BB_PORTC_PRESERVE) | ((x) & ~BB_PORTC_PRESERVE)))

// Handshake-Timeout in Microsekunden (ESP32 I2C max ~1ms pro Zugriff)
#define BB_ACK_TIMEOUT_US  50000

// Handshake initialisieren (in setup() aufrufen)
void bbHandshakeInit() {
  BB_HANDSHAKE_PORT |=  (1 << BB_WR_BIT);   // PC4 HIGH (idle) — vor DDR!
  BB_HANDSHAKE_PORT |=  (1 << BB_RD_BIT);   // PC5 Pull-up (RD idle = HIGH)
  BB_HANDSHAKE_DDR  |=  (1 << BB_WR_BIT);   // PC4 = Ausgang
  BB_HANDSHAKE_DDR  &= ~(1 << BB_RD_BIT);   // PC5 = Eingang
  BB_BTN_DDR &= ~(1 << BB_BTN_BIT);  // PC3 = Eingang
  PORTC      |=  (1 << BB_BTN_BIT);  // PC3 Pull-up
}

// Warte auf Ende der Kommunikation (BUS_IDLE)
bool waitForBusIdle() {
  uint16_t t = 0;
  while (BB_HANDSHAKE_PIN & (1 << BB_RD_BIT) & BB_HANDSHAKE_PIN & (1 << BB_WR_BIT)) {
    delayMicroseconds(100);
    if (++t > (BB_ACK_TIMEOUT_US)) {
      Serial.println(F("[SEND] TIMEOUT — kein BUS_IDLE"));
      return false;
    }
  }
  return true;
}    

// Warten bis ESP32 RD auf HIGH setzt -> ESP32 ist ready
bool waitForEspReady() {
  uint16_t t = 0;
  while (BB_HANDSHAKE_PIN & (1 << BB_RD_BIT)) {
    delayMicroseconds(100);
    if (++t > (BB_ACK_TIMEOUT_US)) {
      Serial.println(F("[SEND] TIMEOUT — kein READY vom ESP"));
      return false;
    }
  }
  return true;
}

// Warten bis ESP32 RD auf LOW zieht -> ESP32 bestätigt
bool waitForEspAck() {
  uint16_t t = 0;
  while (!(BB_HANDSHAKE_PIN & (1 << BB_RD_BIT))) {
    delayMicroseconds(100);
    if (++t > (BB_ACK_TIMEOUT_US)) {
      Serial.println(F("[SEND] TIMEOUT — kein ACK von ESP"));
      return false;
    }
  }
  return true;
}

// Einen Frame senden mit Handshake.
// Gibt true zurück wenn ESP32 ACK gegeben hat, false bei Timeout.
// PC4 (WR) als Ausgang sicherstellen — wird durch ADC_DDR-Zuweisungen gelöscht
bool sendToEsp(uint8_t id, uint8_t data) {
  BB_HANDSHAKE_DDR |= (1 << BB_WR_BIT);

  if (!waitForBusIdle()) {
    return false;
  }

  // Bus als Ausgang, ID + Data anlegen
  BUS_ID_DDR   |= 0x0F;
  BUS_DATA_DDR  = 0xFF;
  BUS_ID_PORT   = (BUS_ID_PORT & 0xF0) | (id & 0x0F);
  BUS_DATA_PORT = data;

  // WR = LOW: "Frame liegt an"
  BB_HANDSHAKE_PORT &= ~(1 << BB_WR_BIT);

  if (!waitForEspReady()) {
    Serial.println(F("[SEND] keine Ready erhalten"));
    BB_HANDSHAKE_PORT |= (1 << BB_WR_BIT);
    DDRB = 0x00;   DDRE = 0x00;
    PORTB = 0xFF;  PORTE = 0xFF;
    return false;
  }

  // WR = HIGH: "Übertragung abgeschlossen"
  BB_HANDSHAKE_PORT |= (1 << BB_WR_BIT);

  if (!waitForEspAck()) {
    Serial.println(F("[SEND] keine Lesebestätigung erhalten"));
    DDRB = 0x00;   DDRE = 0x00;
    PORTB = 0xFF;  PORTE = 0xFF;
    return false;
  }

  // Bus freigeben
  DDRB = 0x00;   DDRE = 0x00;
  PORTB = 0xFF;  PORTE = 0xFF;

  return true;
}

// TYPE + PINS senden (nach jeder Messung aufrufen)
void reportComponent() {
  uint8_t type = 0x00;
  uint8_t pins = 0x00;
  ValueCounter = 0;

  switch (Check.Found) {
    case COMP_BJT:
      type = (Check.Type == TYPE_NPN) ? 0x01 : 0x11;
      pins = ((BJT.E + 1) & 0x3)
           | (((BJT.B + 1) & 0x3) << 2)
           | (((BJT.C + 1) & 0x3) << 4);
      break;
    case COMP_FET:
      if      (Check.Type & TYPE_JFET)        type = (Check.Type & TYPE_N_CHANNEL) ? 0x04 : 0x14;
      else if (Check.Type & TYPE_ENHANCEMENT) type = (Check.Type & TYPE_N_CHANNEL) ? 0x02 : 0x12;
      else                                    type = (Check.Type & TYPE_N_CHANNEL) ? 0x03 : 0x13;
      pins = ((FET.S + 1) & 0x3)
           | (((FET.G + 1) & 0x3) << 2)
           | (((FET.D + 1) & 0x3) << 4);
      break;
    case COMP_IGBT:
      type = 0x05;
      pins = ((FET.S + 1) & 0x3)
           | (((FET.G + 1) & 0x3) << 2)
           | (((FET.D + 1) & 0x3) << 4);
      break;
    case COMP_DIODE:
      type = (Check.Diodes > 1) ? 0x19 : 0x09;
      pins = ((Diodes[0].A + 1) & 0x3)
           | (((Diodes[0].C + 1) & 0x3) << 2);
      break;
    case COMP_RESISTOR:
      type = (Check.Resistors > 1) ? 0x16 : 0x06;
      pins = ((Resistors[0].A + 1) & 0x3)
           | (((Resistors[0].B + 1) & 0x3) << 2);
      break;
    case COMP_CAPACITOR:
      type = 0x07;
      pins = ((Caps[0].A + 1) & 0x3)
           | (((Caps[0].B + 1) & 0x3) << 2);
      break;
    case COMP_THYRISTOR:
      type = 0x0A;
      pins = ((BJT.B + 1) & 0x3)
           | (((BJT.C + 1) & 0x3) << 2)
           | (((BJT.E + 1) & 0x3) << 4);
      break;
    case COMP_TRIAC:
      type = 0x0B;
      pins = ((BJT.B + 1) & 0x3)
           | (((BJT.C + 1) & 0x3) << 2)
           | (((BJT.E + 1) & 0x3) << 4);
      break;
    case COMP_INDUCTOR:
      type = 0x08;
      pins = ((Resistors[0].A + 1) & 0x3)
           | (((Resistors[0].B + 1) & 0x3) << 2);
      break;
    default:
      type = 0x00; pins = 0x00;
      break;
  }

  sendToEsp(0x00, type);
  sendToEsp(0x01, pins);
}

// Kommando vom ESP32 empfangen.
// Wird in loop() aufgerufen wenn RD (PC5) = HIGH erkannt wurde.
// Gibt true zurück wenn ein gültiges Kommando (cmd != 0x00) gelesen wurde.
bool checkBrutzelBoyCommand(uint8_t &cmd, uint8_t &param) {
  // Bus als Eingang mit Pull-ups
  DDRB = 0x00;   DDRE = 0x00;
  PORTB = 0xFF;  PORTE = 0xFF;
  BUS_ID_DDR  &= ~0x0F;
  SetADCHiz();   // PC0-PC2 als Eingang — lässt PC4 (WR) unberührt

  // Schritt 1: WR=LOW — "ATmega bereit zum Lesen"
  BB_HANDSHAKE_PORT &= ~(1 << BB_WR_BIT);

  // Schritt 2: Warten auf RD=HIGH ("Daten gültig")
  if(!waitForEspAck()) {
    Serial.println(F("[READ] TIMEOUT — kein RD=HIGH vom ESP32"));
    BB_HANDSHAKE_PORT |= (1 << BB_WR_BIT);
    return false;
  }

  // Schritt 3: Daten lesen
  cmd   = PINE & 0x0F;
  param = PINB;
Serial.print(F("[READ] PINE=0x")); Serial.print(PINE, HEX);
Serial.print(F(" PINB=0x")); Serial.print(PINB, HEX);
Serial.print(F(" DDRE=0x")); Serial.println(DDRE, HEX);

  // Schritt 4: WR=HIGH — "Kommando gelesen, fertig"
  BB_HANDSHAKE_PORT |= (1 << BB_WR_BIT);
  waitForEspAck(); // close communication

  Serial.print(F("[CMD] cmd=0x")); Serial.print(cmd, HEX);
  Serial.print(F(" param=0x"));   Serial.println(param, HEX);

  return (cmd != 0x00);
}

// ================================================================

//Program control
byte                          RunsPassed;        // Counter for successful measurements
byte                          RunsMissed;        // Counter for failed/missed measurements
byte                          ErrFnd;            // An Error is occured

//Setup function
void setup()
{
  bbHandshakeInit();                             // Handshake-Pins initialisieren

  //Disable power on spi, twi, timer2
  power_spi_disable();
  power_twi_disable();
  power_timer2_disable();

  Serial.begin(115200);                          //BrutzelBoy: höhere Baudrate
  Serial.print(X("A  R  D  U  T  E  S  T  E  R "));

  //Setup 
  ADCSRA = (1 << ADEN) | ADC_CLOCK_DIV;          //Enable ADC and set clock divider 
  MCUSR &= ~(1 << WDRF);                         //Reset watchdog flag 
  DIDR0 = 0b00010111;                            // Bit 5 (ADC5/PC5 = RD) nicht deaktivieren                           
  wdt_disable();                                 //Disable watchdog 

  //Default offsets and values
  Config.Samples = ADC_SAMPLES;                  //Number of ADC samples 
  Config.AutoScale = 0;  //Disable ADC auto scaling (ATmega328PB: Bandgap settling too slow)
  Config.RefFlag = 1;                            //No ADC reference set yet 
  delay(100);
  
  //Reset variables
  RunsMissed = 0;
  RunsPassed = 0;
  Config.TesterMode = MODE_CONTINOUS;            //Set default mode: continous
  LoadAdjust();                                  //Load adjustment values
  Serial.print(X("A  R  D  U  T  E  S  T  E  R "));
  lcd_fixed_string(Version_str);                 //Print Ardutester Version
  Serial.println();
  Serial.println(X("      By PighiXXX & PaoloP"));
  Serial.println(X("original version by Markus Reschke"));
  Serial.println();
  delay(100);
}

void startTest() {
  // ── Variablen zurücksetzen ────────────────────────────────────
  Check.Found = COMP_NONE;
  Check.Type = 0;
  Check.Done = 0;
  Check.Diodes = 0;
  Check.Resistors = 0;
  BJT.hFE = 0;
  BJT.I_CE0 = 0;

  // ── BUSY senden — sofort, bevor irgendwas gemessen wird ──────
  // BrutzelBoy wechselt damit in den Mess-Screen.
  sendToEsp(0x0E, 0x01);               // STATUS: BUSY
  sendToEsp(0x0A, 0x04);               // MSG: Probing...

  // ── Hardware-Reset ────────────────────────────────────────────
  SetADCHiz();
  lcd_clear();
  Config.U_Bandgap = ReadU(0x0e);
  Config.Samples = 200;
  Config.U_Bandgap = ReadU(0x0e);
  Config.Samples = ADC_SAMPLES;
  Config.U_Bandgap += Config.RefOffset;

  // ── Messen ───────────────────────────────────────────────────
  if (AllProbesShorted() == 3)
  {
    Serial.println();
    lcd_fixed_string(Remove_str);
    lcd_line(2);
    lcd_fixed_string(ShortCircuit_str);
    sendToEsp(0x0A, 0x02);         // MSG: Short Circuit!
  }
  else
  {
    lcd_line(2);
    lcd_fixed_string(Running_str);
    DischargeProbes();
    if (Check.Found == COMP_ERROR)
    {
      lcd_fixed_string(DischargeFailed_str);
      lcd_line(2);
      lcd_testpin(Check.Probe);
      lcd_data(':');
      lcd_space();
      DisplayValue(Check.U, -3, 'V');
      sendToEsp(0x0A, 0x01);       // MSG: No part found
    }
    else
    {
      CheckProbes(TP1, TP2, TP3);
      CheckProbes(TP2, TP1, TP3);
      CheckProbes(TP1, TP3, TP2);
      CheckProbes(TP3, TP1, TP2);
      CheckProbes(TP2, TP3, TP1);
      CheckProbes(TP3, TP2, TP1);
      if ((Check.Found == COMP_NONE) ||
          (Check.Found == COMP_RESISTOR))
      {
        Serial.println();
        Serial.println(X("Wait a moment..."));
        MeasureCap(TP3, TP1, 0);
        MeasureCap(TP3, TP2, 1);
        MeasureCap(TP2, TP1, 2);
      }
      lcd_clear();
      Serial.print("Found: ");
      switch (Check.Found)
      {
        case COMP_ERROR:     Serial.println(X("Component Error!")); break;
        case COMP_NONE:      Serial.println(X("No Component!"));    break;
        case COMP_RESISTOR:  Serial.println(X("Resistor"));         break;
        case COMP_CAPACITOR: Serial.println(X("Capacitor"));        break;
        case COMP_INDUCTOR:  Serial.println(X("Inductor"));         break;
        case COMP_DIODE:     Serial.println(X("Diode"));            break;
        case COMP_BJT:       Serial.println(X("BJT"));              break;
        case COMP_FET:       Serial.println(X("FET"));              break;
        case COMP_IGBT:      Serial.println(X("IGBT"));             break;
        case COMP_TRIAC:     Serial.println(X("TRIAC"));            break;
        case COMP_THYRISTOR: Serial.println(X("Thyristor"));        break;
      }

      // ── Messdaten senden ──────────────────────────────────
      reportComponent();                   // TYPE + PINS
      switch (Check.Found)
      {
        case COMP_ERROR:     ShowError();    break;
        case COMP_DIODE:     ShowDiode();    break;
        case COMP_BJT:       ShowBJT();      break;
        case COMP_FET:       ShowFET();      break;
        case COMP_IGBT:      ShowIGBT();     break;
        case COMP_THYRISTOR: ShowSpecial();  break;
        case COMP_TRIAC:     ShowSpecial();  break;
        case COMP_RESISTOR:  ShowResistor(); break;
        case COMP_CAPACITOR: ShowCapacitor();break;
        default:             ShowFail();     break;
      }

      // ── DONE senden — einmalig, kein Spam ─────────────────
      // BrutzelBoy wechselt zum Ergebnis-Screen und bleibt dort.
      // Danach läuft loop() neu und wartet stumm auf den nächsten Start.
      sendToEsp(0x0E, 0x02);         // STATUS: DONE

      RunsMissed = 0;
      RunsPassed++;
    }
  }
  delay(500);
  wdt_disable();
}

void startFrequencyCounter(uint8_t param) {
  // STUB: Frequenzmessung noch nicht implementiert
  Serial.println(F("[CMD] FREQ_METER: nicht implementiert"));
  //sendToEsp(0x0A, 0x01);            // MSG: No part (Platzhalter)
}

void signalGenerator(uint8_t param) {
  // Frequenztabelle gemaess Protokoll:
  //   0x00=1Hz, 0x01=10Hz, 0x02=50Hz, 0x03=100Hz, 0x04=250Hz,
  //   0x05=500Hz, 0x06=1kHz, 0x07=2.5kHz, 0x08=5kHz, 0x09=10kHz,
  //   0x0A=25kHz, 0x0B=50kHz, 0x0C=100kHz, 0x0D=250kHz,
  //   0x0E=500kHz, 0x0F=1MHz, 0x10=2MHz
  //   0xFF = STOPP
  if (param == 0xFF) {
    // Generator stoppen: Timer deaktivieren
    TCCR1B = 0; TCCR1A = 0; R_DDR = 0;
    return;
  }
  // Von PWM_Tool() unterstuetzte Indizes (100Hz - 25kHz):
  //   Protokoll 0x03=100Hz → PWM_Freq_table[0]
  //   Protokoll 0x04=250Hz → PWM_Freq_table[1]
  //   Protokoll 0x05=500Hz → PWM_Freq_table[2]
  //   Protokoll 0x06=1kHz  → PWM_Freq_table[3]
  //   Protokoll 0x07=2.5kHz→ PWM_Freq_table[4]
  //   Protokoll 0x08=5kHz  → PWM_Freq_table[5]
  //   Protokoll 0x09=10kHz → PWM_Freq_table[6]
  //   Protokoll 0x0A=25kHz → PWM_Freq_table[7]
  if (param >= 0x03 && param <= 0x0A) {
    unsigned int freq = PWM_Freq_table[param - 0x03];
    PWM_Tool(freq);
  } else {
    // TODO: Frequenzen ausserhalb PWM_Tool-Bereich (1Hz-50Hz, >25kHz)
    // Protokoll-Indizes 0x00-0x02 (1Hz, 10Hz, 50Hz) und
    // 0x0B-0x10 (50kHz-2MHz) noch nicht implementiert
      Serial.print(F("[CMD] SIG_GEN: Frequenz-Index 0x"));
      Serial.print(param, HEX);
      Serial.println(F(" nicht unterstuetzt"));
  }
}

void pwmGenerator(int8_t param) {
  // param = Duty-Cycle in % (1-99), 0 = STOPP
  // TODO: PWM_Tool() erweitern um Duty-Cycle-Parameter
  // Aktuell: param wird empfangen aber ignoriert, 50% fest
  if (param == 0x00) {
    TCCR1B = 0; TCCR1A = 0; R_DDR = 0;      // STOPP
  } else if (param >= 1 && param <= 99) {
    // TODO: PWM_Tool_WithDuty(freq, param) implementieren
    // Vorlaeufig: 1kHz mit festem 50% Duty-Cycle
      Serial.print(F("[CMD] PWM_GEN: Duty-Cycle "));
      Serial.print(param); Serial.println(F("% (TODO: wird noch ignoriert)"));
    PWM_Tool(1000);
  }
}

void startCalibration(uint8_t param) {
  Serial.println(F("[CMD] CALIBRATE"));
  // Bandgap-Referenz messen — wird von SmallCap() für die Berechnung benötigt
  Config.U_Bandgap = ReadU(0x0e);
  Config.Samples = 200;
  Config.U_Bandgap = ReadU(0x0e);
  Config.Samples = ADC_SAMPLES;
  Config.U_Bandgap += Config.RefOffset;
  sendToEsp(0x0E, 0x03);               // STAT_CAL
  byte calResult = SelfAdjust();
  if (calResult) SaveEEP();
  // Kalibrierwerte senden: VAL1=RiL, VAL2=RiH, VAL3=RZero, VAL4=CapZero+Offsets
  sendToEsp(0x0B, 0x00);               // UNIT: keine Einheit
  sendToEsp(0x02, lowByte(Config.RiL));
  sendToEsp(0x03, highByte(Config.RiL));
  sendToEsp(0x0B, 0x00);
  sendToEsp(0x04, lowByte(Config.RiH));
  sendToEsp(0x05, highByte(Config.RiH));
  sendToEsp(0x0B, 0x00);
  sendToEsp(0x06, lowByte(Config.RZero));
  sendToEsp(0x07, highByte(Config.RZero));
  // VAL4: LO=CapZero, HI=RefOffset+128 (signed→unsigned), extra: CompOffset+128 in TEXT_MSG
  sendToEsp(0x0B, 0x00);
  sendToEsp(0x08, Config.CapZero);
  sendToEsp(0x09, (uint8_t)(Config.RefOffset + 128));
  // CompOffset als extra DATA in TEXT_MSG (0x0A), Wert +128
  sendToEsp(0x0A, (uint8_t)(Config.CompOffset + 128));
  // Ergebnis: MSG_CAL_DONE (0x08) = OK, STAT_CAL_ERR (0xFF) = Fehler
  if (calResult)
    sendToEsp(0x0A, 0x08);   // MSG_CAL_DONE via TEXT_MSG
  else
    sendToEsp(0x0E, 0xFF);   // STAT_CAL_ERR via SYS_STAT
}

//Main loop
void loop()
{
  /*
  // ── DIAGNOSE: alle 500ms Pin-Zustand loggen ──────────────────
  static uint32_t diag_last = 0;
  if (millis() - diag_last > 500) {
    diag_last = millis();
    Serial.print(F("[DIAG] PINC=0x")); Serial.print(PINC, HEX);
    Serial.print(F(" DDRC=0x")); Serial.print(DDRC, HEX);
    Serial.print(F(" PORTC=0x")); Serial.print(PORTC, HEX);
    Serial.print(F(" WR=")); Serial.print((PINC >> BB_WR_BIT) & 1);
    Serial.print(F(" RD=")); Serial.print((PINC >> BB_RD_BIT) & 1);
    Serial.print(F(" PINB=0x")); Serial.print(PINB, HEX);
    Serial.print(F(" PINE=0x")); Serial.println(PINE, HEX);
  }
  //*/

  uint8_t cmd = 0;
  uint8_t param = 0;

  if (!(BB_BTN_PIN & (1 << BB_BTN_BIT))) {
    // Physischer Taster gedrückt
    Serial.println(F("[LOOP] Testbutton is pressed"));
    cmd = 0x1;  // START_TEST
  } else if (!(BB_HANDSHAKE_PIN & (1 << BB_RD_BIT))) {
    Serial.println(F("[LOOP] Received data from Brutzelboy"));
    checkBrutzelBoyCommand(cmd, param);
  }
  // Kommando ausfuehren
  switch (cmd) {
    case 0x0:  // NOP
      break;

    case 0x1:  // START_TEST - neuen Bauteiltest starten
      startTest();
      break;

    case 0x2:  // FREQ_METER - Frequenzmessung
      startFrequencyCounter(param);
      break;

    case 0x3:  // SIG_GEN - Signalgenerator
      signalGenerator(param);
      break;

    case 0x4:  // PWM_GEN - PWM mit variablem Duty-Cycle
      pwmGenerator(param);
      break;

    case 0x5:  // C_ESR_METER - Kondensator + ESR Messung
      // STUB: ESR-Messung noch nicht implementiert
        Serial.println(F("[CMD] C_ESR_METER: nicht implementiert"));
      break;

    case 0x6:  // SELF_TEST - Kalibrierung / Selbsttest
      SelfTest();
      break;

    case 0x7:  // POWER_OFF - Standby
      wdt_disable();
      Serial.println(F("[CMD] POWER_OFF"));
      set_sleep_mode(SLEEP_MODE_PWR_DOWN);
      sleep_enable();
      sleep_cpu();
      sleep_disable();
      break;

    case 0x8:  // CALIBRATE - SelfAdjust + SaveEEP
      startCalibration(param);
      break;

    case 0x9:  // DEFAULT_PAR - Kalibrierungswerte zurücksetzen
      Serial.println(F("[CMD] DEFAULT_PAR"));
      DefaultPar();
      break;

    default:
        Serial.print(F("[CMD] Unbekanntes Kommando: 0x"));
        Serial.println(cmd, HEX);
      break;
  }
}

//Set ADC port to HiZ mode 
void SetADCHiz(void)
{
  ADC_DDR &= ~(1<<TP1);                                                           
  ADC_DDR &= ~(1<<TP2);
  ADC_DDR &= ~(1<<TP3);
}

//Set ADC port low
void SetADCLow(void)
{
  ADC_PORT &= ~(1<<TP1);                                                           
  ADC_PORT &= ~(1<<TP2);
  ADC_PORT &= ~(1<<TP3);
}

//Setup probes, bitmasks for probes and test resistors
void UpdateProbes(byte Probe1, byte Probe2, byte Probe3)
{
  //DSt probe IDs
  Probes.Pin_1 = Probe1;
  Probes.Pin_2 = Probe2;
  Probes.Pin_3 = Probe3;
  //Setup masks using bitmask tables
  Probes.Rl_1 = Rl_table[Probe1];
  Probes.Rh_1 = Probes.Rl_1 + Probes.Rl_1;
  Probes.ADC_1 = ADC_table[Probe1];
  Probes.Rl_2 = Rl_table[Probe2];
  Probes.Rh_2 = Probes.Rl_2 + Probes.Rl_2;
  Probes.ADC_2 = ADC_table[Probe2];
  Probes.Rl_3 = Rl_table[Probe3];
  Probes.Rh_3 = Probes.Rl_3 + Probes.Rl_3;
}

//Check for a short circuit between two probes
byte ShortedProbes(byte Probe1, byte Probe2)
{
  byte                        Flag = 0;          //Return value
  unsigned int                U1;                //Voltage at probe #1 in mV 
  unsigned int                U2;                //Voltage at probe #2 in mV 
  /*
     Set up a voltage divider between the two probes:
      - Probe1: Rl pull-up
      - Probe2: Rl pull-down
      - third probe: HiZ
  */
  R_PORT = Rl_table[Probe1];
  R_DDR = Rl_table[Probe1] | Rl_table[Probe2];
  //Read voltages
  U1 = ReadU(Probe1);
  U2 = ReadU(Probe2);
  /*
     We expect both probe voltages to be about the same and
     to be half of Vcc (allowed difference +/- 30mV).
  */
  if ((U1 > UREF_VCC/2 - 30) && (U1 < UREF_VCC/2 + 30))
  { 
    if ((U2 > UREF_VCC/2 - 30) && (U2 < UREF_VCC/2 + 30))
    {
      Flag = 1;
    }    
  }
  //Reset port
  R_DDR = 0;
  return Flag;
}

 //Check for a short circuit between all probes
 byte AllProbesShorted(void)
{
  byte                        Flag = 0;          //Return value
  //Check all possible combinations
  Flag = ShortedProbes(TP1, TP2);
  Flag += ShortedProbes(TP1, TP3);
  Flag += ShortedProbes(TP2, TP3);
  return Flag;  
}

//Try to discharge any connected components, e.g. capacitors
void DischargeProbes(void)
{
  byte                        Counter;           //Loop control 
  byte                        Limit = 40;        //Sliding timeout (2s) 
  byte                        ID;                //Test pin 
  byte                        DischargeMask;     //Bitmask 
  unsigned int                U_c;               //Current voltage 
  unsigned int                U_old[3];          //Old voltages 
  //Set probes to a save discharge mode (pull-down via Rh), Set ADC port to HiZ input
  SetADCHiz();
  SetADCLow();
  //All probe pins: Rh and Rl pull-down
  R_PORT = 0;
  R_DDR = RH_MASK(TP1) | RH_MASK(TP2) | RH_MASK(TP3);
  R_DDR |= RL_MASK(TP1) | RL_MASK(TP2) | RL_MASK(TP3);
  //Get current voltages
  U_old[0] = ReadU(TP1);
  U_old[1] = ReadU(TP2);
  U_old[2] = ReadU(TP3);
  /*
     Try to discharge probes
      - We check if the voltage decreases over time.
      - A slow discharge rate will increase the timeout to support
        large caps.
      - A very large cap will discharge too slowly and an external voltage
        maybe never :-)
  */
  Counter = 1;
  ID = 2;
  DischargeMask = 0;
  while (Counter > 0)
  {
    ID++;                                        //Next probe
    if (ID > 2) ID = 0;                          //Start with probe #1 again
    if (DischargeMask & (1 << ID))               //Skip discharged probe
      continue;
    U_c = ReadU(ID);                             //Get voltage of probe 
    if (U_c < U_old[ID])                         //Voltage decreased 
    {
      U_old[ID] = U_c;                           //Update old value 
      //Adapt timeout based on discharge rate
      if ((Limit - Counter) < 20)
      {
        //Increase timeout while preventing overflow
        if (Limit < (255 - 20)) Limit += 20;
      }
      Counter = 1;                               //Reset no-changes counter 
    }
    else                                         //Voltage not decreased 
    {
      //Increase limit if we start at a low voltage
      if ((U_c < 10) && (Limit <= 40)) Limit = 80;
      Counter++;                                 //Increase no-changes counter
    }
    if (U_c <= CAP_DISCHARGED)                   //Seems to be discharged
    {
      DischargeMask |= (1 << ID);                //Set flag
    }
    else if (U_c < 800)                          //Extra pull-down
    {
      //It's save now to pull-down probe pin directly
      ADC_DDR |= ADC_table[ID];
    }
    if (DischargeMask == 0b00000111)             //All probes discharged
    {
      Counter = 0;                               //End loop
    }
    else if (Counter > Limit)                    //No decrease for some time
    {
      //Might be a battery or a super cap
      Check.Found = COMP_ERROR;                  //Report error 
      Check.Type = TYPE_DISCHARGE;               //Discharge problem 
      Check.Probe = ID;                          //Save probe 
      Check.U = U_c;                             //Save voltage 
      Counter = 0;                               //End loop 
    }
    else                                         //Go for another round 
    {
      wdt_reset();                               //Reset watchdog 
      delay(50);                                 //Wait for 50ms 
    }
  }
  //Reset probes
  R_DDR = 0;                                     //Set resistor port to input mode
  SetADCHiz();                                   //Set ADC port to input mode 
}

//Pull probe up/down via probe resistor for 1 or 10 ms
void PullProbe(byte Mask, byte Mode)
{
  //Set pull mode
  if (Mode & FLAG_PULLUP) R_PORT |= Mask;        //Pull-up 
  else R_PORT &= ~Mask;                          //Pull-down 
  R_DDR |= Mask;                                 //Enable pulling 
  if (Mode & FLAG_1MS) delay(1);                 //Wait 1ms 
  else delay(10);                                //Wait 10ms 
  //Reset pulling 
  R_DDR &= ~Mask;                                //Set to HiZ mode 
  R_PORT &= ~Mask;                               //Set 0
}

//Rescale value
unsigned long RescaleValue(unsigned long Value, signed char Scale, signed char NewScale)
{
  unsigned long               NewValue;
  NewValue = Value;                              //Take old value
  while (Scale != NewScale)                      //Processing loop
  {
    if (NewScale > Scale)                        //Upscale
    {
      NewValue /= 10;
      Scale++;
    }
    else                                         //Downscale
    {
      NewValue *= 10;
      Scale--;
    }
  }
  return NewValue;
}

//Lokup a voltage/ratio based factor in a table and interpolate it's value
unsigned int GetFactor(unsigned int U_in, byte ID)
{
  unsigned int                Factor;            //Return value 
  unsigned int                U_Diff;            //Voltage difference to table start
  unsigned int                Fact1, Fact2;      //Table entries 
  unsigned int                TabStart;          //Table start voltage 
  unsigned int                TabStep;           //Table step voltage 
  unsigned int                TabIndex;          //Table entries (-2)
  unsigned int                *Table;
  byte                        Index;             //Table index
  byte                        Diff;              //Difference to next entry
  //Setup table specific stuff
  if (ID == TABLE_SMALL_CAP)
  {
    TabStart = 1000;                             //Table starts at 1000mV 
    TabStep = 50;                                //50mV steps between entries 
    TabIndex = 7;                                //Entries in table - 2 
    Table = (unsigned int *)&SmallCap_table[0];  //Pointer to table start
  }
  else if (ID == TABLE_LARGE_CAP)
  {
    TabStart = 300;                              //Table starts at 1000mV 
    TabStep = 25;                                //25mV steps between entries 
    TabIndex = 42;                               //Entries in table - 2 
    Table = (unsigned int *)&LargeCap_table[0];  //Pointer to table start 
  }
  else if (ID == TABLE_INDUCTOR)
  {
    TabStart = 200;                              //Table starts at 200 
    TabStep = 25;                                //Steps between entries 
    TabIndex = 30;                               //Entries in table - 2 
    Table = (unsigned int *)&Inductor_table[0];  //Pointer to table start 
  }
  else
  {
    return 0;
  }
  //We interpolate the table values corresponding to the given voltage/ratio, difference to start of table
  if (U_in >= TabStart) U_Diff = U_in - TabStart;  
  else U_Diff = 0;
  //Calculate table index
  Index = U_Diff / TabStep;                      //Index (position in table) 
  Diff = U_Diff % TabStep;                       //Difference to index 
  Diff = TabStep - Diff;                         //Difference to next entry 
  //Prevent index overflow
  if (Index > TabIndex) Index = TabIndex;
  //Get values for index and next entry
  Table += Index;                                //Advance to index 
  Fact1 = *(Table);
  Table++;                                       //Next entry 
  Fact2 = *(Table);
  //Interpolate values based on the difference
  Factor = Fact1 - Fact2;
  Factor *= Diff;
  Factor += TabStep / 2;
  Factor /= TabStep;
  Factor += Fact2;
  return Factor;
}

//Identify component
void CheckProbes(byte Probe1, byte Probe2, byte Probe3)
{
  byte                        Flag;              //Temporary value 
  unsigned int                U_Rl;              //Voltage across Rl (load) 
  unsigned int                U_1;               //Voltage #1 
  //Init
  if (Check.Found == COMP_ERROR) return;         //Skip check on any error 
  wdt_reset();                                   //Reset watchdog 
  UpdateProbes(Probe1, Probe2, Probe3);          //Update bitmasks 
  /*
     We measure the current from probe 2 to ground with probe 1 pulled up
     to 5V and probe 3 in HiZ mode to determine if we got a self-conducting
     part, i.e. diode, resistor or depletion-mode FET. Rl is used as current
     shunt.
   
     In case of a FET we have to take care about the gate charge based on
     the channel type.
  */
  //Set probes: Gnd -- Rl -- probe-2 / probe-1 -- Vcc
  R_PORT = 0;                                    //Set resistor port to Gnd 
  R_DDR = Probes.Rl_2;                           //Pull down probe-2 via Rl 
  SET_ADC_DDR(Probes.ADC_1);                        //Set probe-1 to output 
  SET_ADC_PORT(Probes.ADC_1);                       //Pull-up probe-1 directly 
  /*
     For a possible n channel FET we pull down the gate for a few ms,
     assuming: probe-1 = D / probe-2 = S / probe-3 = G
  */
  //Discharge gate via Rl
  PullProbe(Probes.Rl_3, FLAG_10MS | FLAG_PULLDOWN);   
  U_Rl = ReadU_5ms(Probes.Pin_2);                //Get voltage at Rl
  /*
     If we got conduction we could have a p channel FET. For any
     other part U_Rl will be the same.
  */
  if (U_Rl >= 977)                               // > 1.4mA
  {
    /*
       For a possible p channel FET we pull up the gate for a few ms,
       assuming: probe-1 = S / probe-2 = D / probe-3 = G
    */
    //Discharge gate via Rl
    PullProbe(Probes.Rl_3, FLAG_10MS | FLAG_PULLUP);   
    U_Rl = ReadU_5ms(Probes.Pin_2);              //Get voltage at Rl
  }
  /*
     If there's some current we could have a depletion-mode FET
     (self-conducting). To skip germanium BJTs with a high leakage current
     we check for a current larger then the usual V_CEO.
   
     Other possibilities:
      - diode or resistor
  */
  if (U_Rl > 490)                                // > 700ÂµA (was 92mV/130ÂµA)
  {
    CheckDepletionModeFET(U_Rl);
  }
  /*
     If there's nearly no conduction (just a small leakage current) between
     probe-1 and probe-2 we might have a semiconductor:
      - BJT
      - enhancement mode FET
      - Thyristor or Triac
      or a large resistor
  */
  if (U_Rl < 977)                                //Load current < 1.4mA
  {
    /*
       check for:
        - PNP BJT (common emitter circuit)
        - p-channel MOSFET (low side switching circuit)
    */
    if (Check.Done == 0)                         //Not sure yet
    {
      //We assume: probe-1 = E / probe-2 = C / probe-3 = B, set probes: Gnd -- Rl - probe-2 / probe-1 -- Vcc
      R_DDR = Probes.Rl_2;                       //Enable Rl for probe-2
      R_PORT = 0;                                //Pull down collector via Rl
      SET_ADC_DDR(Probes.ADC_1);                    //Set probe 1 to output
      SET_ADC_PORT(Probes.ADC_1);                   //Pull up emitter directly
      delay(5);
      R_DDR = Probes.Rl_2 | Probes.Rl_3;         //Pull down base via Rl
      U_1 = ReadU_5ms(Probe2);                   //Get voltage at collector
      //If DUT is conducting we might have a PNP BJT or p-channel FET.
      if (U_1 > 3422)                            //Detected current > 4.8mA
      {
        //Distinguish PNP BJT from p-channel MOSFET
        CheckBJTorEnhModeMOSFET(TYPE_PNP, U_Rl);
      }
    }
    /*
       Check for
        - NPN BJT (common emitter circuit)
        - Thyristor and Triac
        - n-channel MOSFET (high side switching circuit)
    */
    if (Check.Done == 0)                         //Not sure yet
    {
      //We assume: probe-1 = C / probe-2 = E / probe-3 = B, set probes: Gnd -- probe-2 / probe-1 -- Rl -- Vcc
      SET_ADC_DDR(Probes.ADC_2);                    //Set probe-2 to output mode 
      SetADCLow();                               //Pull down probe-2 directly 
      R_DDR = Probes.Rl_1 | Probes.Rl_3;         //Select Rl for probe-1 & Rl for probe-3 
      R_PORT = Probes.Rl_1 | Probes.Rl_3;        //Pull up collector & base via Rl
      U_1 = ReadU_5ms(Probe1);                   //Get voltage at collector
      //If DUT is conducting we might have a NPN BJT, something similar or a n-channel MOSFET.  
      if (U_1 < 1600)                            //Detected current > 4.8mA
      {
        //First check for thyristor and triac
        Flag = CheckThyristorTriac();
        if (Flag == 0)                           //No thyristor or triac
        {
          //We might got a NPN BJT or a n-channel MOSFET.
          CheckBJTorEnhModeMOSFET(TYPE_NPN, U_Rl);
        }
      }
    }
  }
  /*
     If there's conduction between probe-1 and probe-2 we might have a
      - diode (conducting)
      - small resistor (checked later on)
  */
  else                                           //Load current > 1.4mA
  {
    //We check for a diode even if we already found a component to get Vf, since there could be a body/protection diode of a transistor.
    CheckDiode();
  }
  //Check for a resistor.
  if ((Check.Found == COMP_NONE) ||
      (Check.Found == COMP_RESISTOR))
  {
    CheckResistor();
  }
  //Otherwise run some final checks.
  else
  {
    //Verify a MOSFET
    if ((Check.Found == COMP_FET) && (Check.Type & TYPE_MOSFET))
      VerifyMOSFET();
  }
  //Clean up
  SetADCHiz();                                   //Set ADC port to HiZ mode 
  SetADCLow();                                   //Set ADC port low 
  R_DDR = 0;                                     //Set resistor port to HiZ mode 
  R_PORT = 0;                                    //Set resistor port low 
}

//Read ADC and return voltage in mV
unsigned int ReadU(byte Probe)
{
  unsigned int                U;                 //Return value (mV) 
  byte                        Counter;           //Loop counter 
  unsigned long               Value;             //ADC value
  boolean                     cycle;
  Probe |= (1 << REFS0);                         //Use internal reference anyway
  do {
    cycle = false;
    ADMUX = Probe;                                 //Set input channel and U reference
    //If voltage reference has changed run a dummy conversion (recommended by datasheet)
    Counter = Probe & (1 << REFS1);                //Get REFS1 bit flag 
    if (Counter != Config.RefFlag)
    {
      waitus(100);                               //Time for voltage stabilization 
      ADCSRA |= (1 << ADSC);                     //Start conversion 
      while (ADCSRA & (1 << ADSC));              //Wait until conversion is done 
      Config.RefFlag = Counter;                  //Update flag 
    }
    //Sample ADC readings
    Value = 0UL;                                 //Reset sampling variable
    Counter = 0;                                 //Reset counter 
    while (Counter < Config.Samples)             //Take samples
    {
      ADCSRA |= (1 << ADSC);                     //Start conversion
      while (ADCSRA & (1 << ADSC));              //Wait until conversion is done
      Value += ADCW;                             //Add ADC reading
      //Auto-switch voltage reference for low readings
      if (Counter == 4)
      {
        if (((unsigned int)Value < 1024) && !(Probe & (1 << REFS1)) && (Config.AutoScale == 1))
        {
          Probe |= (1 << REFS1);                 //Select internal bandgap reference 
          cycle = true;                          //Re-run sampling
         break;
        }
      }
      Counter++;                                 //One less to do
    }
  } while (cycle);
  //Convert ADC reading to voltage - single sample: U = ADC reading * U_ref / 1024
  //Get voltage of reference used
  if (Probe & (1 << REFS1)) U = Config.U_Bandgap;//Bandgap reference
  else U = UREF_VCC;                             //Vcc reference 
  //Convert to voltage;
  Value *= U;                                    //ADC readings * U_ref
  Value /= 1024;                                 // / 1024 for 10bit ADC 
  //De-sample to get average voltage
  Value /= Config.Samples;
  U = (unsigned int)Value;
  return U; 
}

//Wait 5ms and then read ADC
unsigned int ReadU_5ms(byte Probe)
{
   delay(5);                                     //Wait 5ms
   return (ReadU(Probe));
}

//Wait 20ms and then read ADC
unsigned int ReadU_20ms(byte Probe)
{
  delay(20);                                     //Wait 20ms
  return (ReadU(Probe));
}

//Wait Functions
void waitus(byte microsec) {
  delayMicroseconds(microsec);
}

//Measure hFE of BJT in common collector circuit (emitter follower)
unsigned long Get_hFE_C(byte Type)
{
  unsigned long               hFE;               //Return value 
  unsigned int                U_R_e;             //Voltage across emitter resistor 
  unsigned int                U_R_b;             //Voltage across base resistor 
  unsigned int                Ri;                //Internal resistance of ÂµC
  /*
     Measure hFE for a BJT in common collector circuit
     (emitter follower):
      - hFE = (I_e - I_b) / I_b
      - measure the voltages across the resistors and calculate the currents
        (resistor values are well known)
      - hFE = ((U_R_e / R_e) - (U_R_b / R_b)) / (U_R_b / R_b)
  */
  //Setup probes and get voltages
  if (Type == TYPE_NPN)                          //NPN
  {
    //We assume: probe-1 = C / probe-2 = E / probe-3 = B, set probes: Gnd -- Rl -- probe-2 / probe-1 -- Vcc
    SET_ADC_DDR(Probes.ADC_1);                      //Set probe 1 to output 
    SET_ADC_PORT(Probes.ADC_1);                     //Pull up collector directly 
    R_DDR = Probes.Rl_2 | Probes.Rl_3;           //Select Rl for probe-2 & Rl for probe-3 
    R_PORT = Probes.Rl_3;                        //Pull up base via Rl 
    U_R_e = ReadU_5ms(Probes.Pin_2);             //U_R_e = U_e 
    U_R_b = UREF_VCC - ReadU(Probes.Pin_3);      //U_R_b = Vcc - U_b 
  }
  else                                           //PNP
  {
    //We assume: probe-1 = E / probe-2 = C / probe-3 = B, set probes: Gnd -- probe-2 / probe-1 -- Rl -- Vcc
    SetADCLow();                                 //Set ADC port low 
    SET_ADC_DDR(Probes.ADC_2);                      //Pull down collector directly 
    R_PORT = Probes.Rl_1;                        //Pull up emitter via Rl 
    R_DDR = Probes.Rl_1 | Probes.Rl_3;           //Pull down base via Rl 
    U_R_e = UREF_VCC - ReadU_5ms(Probes.Pin_1);  //U_R_e = Vcc - U_e 
    U_R_b = ReadU(Probes.Pin_3);                 //U_R_b = U_b 
  }
  if (U_R_b < 10)                                //I_b < 14ÂµA -> Darlington 
  {
    //Change base resistor from Rl to Rh and measure again
    if (Type == TYPE_NPN)                        //NPN 
    {    
      R_DDR = Probes.Rl_2 | Probes.Rh_3;         //Select Rl for probe-2 & Rh for probe-3 
      R_PORT = Probes.Rh_3;                      //Pull up base via Rh 
      U_R_e = ReadU_5ms(Probes.Pin_2);           //U_R_e = U_e 
      U_R_b = UREF_VCC - ReadU(Probes.Pin_3);    //U_R_b = Vcc - U_b 
      Ri = Config.RiL;                           //Get internal resistor 
    }
    else                                         //PNP 
    {
      R_DDR = Probes.Rl_1 | Probes.Rh_3;         //Pull down base via Rh 
      U_R_e = UREF_VCC - ReadU_5ms(Probes.Pin_1);//U_R_e = Vcc - U_e 
      U_R_b = ReadU(Probes.Pin_3);               //U_R_b = U_b
      Ri = Config.RiH;                           //Get internal resistor
    }
    /*
       Since I_b is so small vs. I_e we'll neglect it and use
        hFE = I_e / I_b
            = (U_R_e / R_e) / (U_R_b / R_b)
            = (U_R_e * R_b) / (U_R_b * R_e)
    */
    if (U_R_b < 1) U_R_b = 1;                    //Prevent division by zero 
    hFE =  U_R_e * R_HIGH;                       //U_R_e * R_b 
    hFE /= U_R_b;                                // / U_R_b 
    hFE *= 10;                                   //Upscale to 0.1 
    hFE /= (R_LOW * 10) + Ri;                    // / R_e in 0.1 Ohm 
  }
  else                                           //I_b > 14ÂµA -> standard 
  {
    /*
       Both resistors are the same (R_e = R_b): 
        - hFE = ((U_R_e / R_e) - (U_R_b / R_b)) / (U_R_b / R_b)
        -     = (U_R_e - U_R_b) / U_R_b 
    */
    hFE = (unsigned long)((U_R_e - U_R_b) / U_R_b);
  }
  return hFE;
}

//Measure the gate threshold voltage of a depletion-mode MOSFET
void GetGateThreshold(byte Type)
{
  unsigned long               Uth = 0;           //Gate threshold voltage 
  byte                        Drain_Rl;          //Rl bitmask for drain 
  byte                        Drain_ADC;         //ADC bitmask for drain 
  byte                        PullMode;
  byte                        Counter;           //Loop counter 
   //Init variables
  if (Type & TYPE_N_CHANNEL)                     //n-channel
  {
    /* 
      We assume: probe-1 = D / probe-2 = S / probe-3 = G
       probe-2 is still pulled down directly
       probe-1 is still pulled up via Rl 
    */
    Drain_Rl =  Probes.Rl_1;
    Drain_ADC = Probes.ADC_1;
    PullMode = FLAG_10MS | FLAG_PULLDOWN;
  }
  else                                           //p-channel
  {
    /*
     We assume: probe-1 = S / probe-2 = D / probe-3 = G
      probe-2 is still pulled down via Rl
      probe-1 is still pulled up directly 
    */
    Drain_Rl =  Probes.Rl_2;
    Drain_ADC = Probes.ADC_2;
    PullMode = FLAG_10MS | FLAG_PULLUP;
  }
  //For low reaction times we use the ADC directly.
  //Sanitize bit mask for drain to prevent a never-ending loop
  Drain_ADC &= 0b00000111;                       //drain 
  ADMUX = Probes.Pin_3 | (1 << REFS0);           //Select probe-3 for ADC input 
  //Sample 10 times
  for (Counter = 0; Counter < 10; Counter++) 
  {
    wdt_reset();                                 //Reset watchdog
    //Discharge gate via Rl for 10 ms
    PullProbe(Probes.Rl_3, PullMode);
    //Pull up/down gate via Rh to slowly charge gate
    R_DDR = Drain_Rl | Probes.Rh_3;
    //Wait until FET conducts
    if (Type & TYPE_N_CHANNEL)                   //n-channel
    {
      //FET conducts when the voltage at drain reaches low level
      while (ADC_PIN & Drain_ADC);
    }
    else                                         //p-channel
    {
      //FET conducts when the voltage at drain reaches high level
      while (!(ADC_PIN & Drain_ADC));             
    }
    R_DDR = Drain_Rl;                            //Set probe-3 to HiZ mode
    //Get voltage of gate
    ADCSRA |= (1 << ADSC);                       //Start ADC conversion
    while (ADCSRA & (1 << ADSC));                //Wait until conversion is done
    //Add ADC reading
    if (Type & TYPE_N_CHANNEL)                   //n-channel
    {
      Uth += ADCW;                               //U_g = U_measued
    }
    else                                         //p-channel
    {
      Uth += (1023 - ADCW);                      //U_g = Vcc - U_measured
    }
  }
  //Calculate V_th 
  Uth /= 10;                                     //Average of 10 samples
  Uth *= UREF_VCC;                               //Convert to voltage 
  Uth /= 1024;                                   //Using 10 bit resolution 
  //Save data
  FET.V_th = (unsigned int)Uth;
}

//Measure leakage current
unsigned int GetLeakageCurrent(void)
{
  unsigned int                I_leak = 0;        //Return value
  unsigned int                U_Rl;              //Voltage at Rl 
  unsigned int                R_Shunt;           //Shunt resistor
  uint32_t                    Value;
  /*
     Setup probes:
      - use Rl as current shunt
      - probe-1 = pos / probe-2 = neg / probe-3 = HiZ
        Diode:    probe-1 = cathode /  probe-2 = anode
        NPN BJT:  probe-1 = collector / probe-2 = emitter
        PNP BJT:  probe-1 = emitter / probe-2 = collector
  */
  R_PORT = 0;                                    //Set resistor port to Gnd 
  R_DDR = Probes.Rl_2;                           //Pull down probe-2 via Rl 
  SET_ADC_DDR(Probes.ADC_1);                        //Set probe-1 to output 
  SET_ADC_PORT(Probes.ADC_1);                       //Pull-up probe-1 directly
  U_Rl = ReadU_5ms(Probes.Pin_2);                //Get voltage at Rl
  //Calculate current
  R_Shunt = Config.RiL + (R_LOW * 10);           //Consider internal resistance of MCU (0.1 Ohms) 
  R_Shunt += 5;                                  //For rounding 
  R_Shunt /= 10;                                 //Scale to Ohms 
  Value = U_Rl * 100000;                         //Scale to 10nV 
  Value /= R_Shunt;                              //in 10nA 
  Value += 55;                                   //For rounding 
  Value /= 100;                                  //Scale to ÂµA 
  I_leak = Value;
  //Clean up
  SetADCHiz();                                   //Set ADC port to HiZ mode
  SetADCLow();                                   //Set ADC port low 
  R_DDR = 0;                                     //Set resistor port to HiZ mode 
  R_PORT = 0;                                    //Set resistor port low
  return I_leak;
}

//Check for diode
void CheckDiode(void)
{
  Diode_Type                  *Diode;            //Pointer to diode 
  unsigned int                U1_Rl;             //Vf #1 with Rl pull-up 
  unsigned int                U1_Rh;             //Vf #1 with Rh pull-up 
  unsigned int                U1_Zero;           //Vf #1 zero 
  unsigned int                U2_Rl;             //Vf #2 with Rl pull-up 
  unsigned int                U2_Rh;             //Vf #2 with Rh pull-up 
  unsigned int                U2_Zero;           //Vf #2 zero 
  wdt_reset();                                   //Reset watchdog
  DischargeProbes();                             //Try to discharge probes
  if (Check.Found == COMP_ERROR) return;         //Skip on error
  /*
     DUT could be:
      - simple diode
      - protection diode of a MOSFET or another device
      - intrinsic diode junction of a BJT
      - small resistor (< 3k)
      - capacitor (> around 22ÂµF)
   
     Solution:
      - Vf of a diode rises with the current within some limits (about twice
        for Si and Schottky). Ge, Z-diodes and LEDs are hard to determine.
        So it might be better to filter out other components.
      - For a MOSFET pretection diode we have to make sure that the MOSFET
        in not conducting, to be able to get Vf of the protection diode.
        So we discharge the gate and run the measurements twice for p and n
        channel FETs.
      - Take care about the internal voltage drop of the ÂµC at the cathode
        for high test currents (Rl).
      - Filter out resistors by the used voltage divider:
        k = Rl + Ri_H + Ri_L
        U_Rh = U_Rl / (k - (k - 1) U_Rl / 5V)
        U_Rl = k U_Rh / (1 + (k - 1) U_Rh / 5V) 
      - Filter out caps by checking the voltage before and after measurement
        with Rh. In 15ms a 22ÂµF cap would be charged from 0 to 7mV, a larger
        cap would have a lower voltage. We have to consider that caps also
        might be charged by EMI.
    
      Hints:
      - Rl drives a current of about 7mA. That's not the best current for
        measuring Vf. The current for Rh is about 10.6ÂµA.
        Most DMMs use 1mA.
  
      Vf #1, supporting a possible p-channel MOSFET
  */
  //We assume: probe-1 = A / probe2 = C, set probes: Gnd -- probe-2 / probe-1 -- Rl or Rh -- Vcc
  SetADCLow();
  SET_ADC_DDR(Probes.ADC_2);                        //Pull down cathode directly
  //R_DDR is set to HiZ by DischargeProbes();
  U1_Zero = ReadU(Probes.Pin_1);                 //Get voltage at anode
  //Measure voltage across DUT (Vf) with Rh
  R_DDR = Probes.Rh_1;                           //Enable Rh for probe-1
  R_PORT = Probes.Rh_1;                          //Pull up anode via Rh
  //Discharge gate
  PullProbe(Probes.Rl_3, FLAG_10MS | FLAG_PULLUP);     
  U1_Rh = ReadU_5ms(Probes.Pin_1);               //Get voltage at anode, neglect voltage at cathode
  //Measure voltage across DUT (Vf) with Rl
  R_DDR = Probes.Rl_1;                           //Enable Rl for probe-1
  R_PORT = Probes.Rl_1;                          //Pull up anode via Rl
  //Discharge gate 
  PullProbe(Probes.Rl_3, FLAG_10MS | FLAG_PULLUP);     
  U1_Rl = ReadU_5ms(Probes.Pin_1);               //Get voltage at anode
  U1_Rl -= ReadU(Probes.Pin_2);                  //Substract voltage at cathode 
  DischargeProbes();                             //Try to discharge probes
  if (Check.Found == COMP_ERROR) return;         //Skip on error
  //Vf #2, supporting a possible n-channel MOSFET
  //We assume: probe-1 = A / probe2 = C, set probes: Gnd -- probe-2 / probe-1 -- Rl or Rh -- Vcc
  SetADCLow();
  SET_ADC_DDR(Probes.ADC_2);                        //Pull down cathode directly 
  U2_Zero = ReadU(Probes.Pin_1);                 //Get voltage at anode 
  //Measure voltage across DUT (Vf) with Rh
  R_DDR = Probes.Rh_1;                           //Enable Rh for probe-1
  R_PORT = Probes.Rh_1;                          //Pull up anode via Rh 
  //Discharge gate
  PullProbe(Probes.Rl_3, FLAG_10MS | FLAG_PULLDOWN);   
  U2_Rh = ReadU_5ms(Probes.Pin_1);               //Get voltage at anode, neglect voltage at cathode 
  //Measure voltage across DUT (Vf) with Rl
  R_DDR = Probes.Rl_1;                           //Enable Rl for probe-1
  R_PORT = Probes.Rl_1;                          //Pull up anode via Rl  
  //Discharge gate
  PullProbe(Probes.Rl_3, FLAG_10MS | FLAG_PULLDOWN);   
  U2_Rl = ReadU_5ms(Probes.Pin_1);               //Get voltage at anode 
  U2_Rl -= ReadU(Probes.Pin_2);                  //Substract voltage at cathode 
  R_PORT = 0;                                    //Stop pulling up
  //Process results, choose between measurements of p and n channel setup
  if (U1_Rl > U2_Rl)                             //The higher voltage wins
  {
    U2_Rl = U1_Rl;
    U2_Rh = U1_Rh;
    U2_Zero = U1_Zero;
  }
  /*
     U_Rh < 10mV for
      - resistor < 1k Ohm
      - very large cap
  */
  if (U2_Rh <= 10) return;                       //Small resistor or very large cap
  /*
     U_Zero <= 2 for resistor or diode 
     U_Zero > 2 for cap or diode
     if U_Zero > 2 then U_Rh - U_Zero < 100 for cap
   
     Hints:
      If U_Zero > 10 and U_Rh is about U_Zero it's a large cap.
      As larger the cap as lower U_Rl (charging time 15ms).
  */
  U1_Zero = U2_Rh - U2_Zero;                     //Voltage difference
  if ((U2_Zero > 2) && (U1_Zero < 100)) return;  //Capacitor
  /*
     The voltages for a resistor will follow the equation:
       k = Rl + Ri_H + Ri_L
       Ul = k U_Rh / (1 + (k - 1) U_Rh / 5V)
     Allow a tolerance of 3%.
     For U_Rh > 40mV we don't need to check for a resistor.
   
     Hint: 
      Actually we could change the thresshold above from 10 t0 40 and
      remove this test completely. The lowest U_Rh measured for a diode was
      56mV for a AA118.
  */
  if (U2_Rh < 40)                                //Resistor (< 3k)
  {
    uint32_t                  a, b;
    //Calculate expected U_Rl based on measured U_Rh in mV, k factor
    b = (R_HIGH * 10) / ((R_LOW * 10) + Config.RiH + Config.RiL);  
    a = b - 1;                                   //k - 1 
    a /= 5;                                      // / 5V 
    a *= U2_Rh;                                  // *U_Rh 
    a += 1000;                                   // +1 (1000 for mV) 
    b *= 1000;                                   //For mV 
    b *= U2_Rh;                                  // *U_Rh 
    b /= a;                                      //U_Rl in mV 
    //Check if calculated U_Rl is within some % of measured value 
    U1_Zero = (unsigned int)b;
    U1_Rl = U1_Zero;
    U1_Rh = U1_Zero;
    U1_Zero /= 50;                               //2%
    U1_Rh += U1_Zero;                            //102%
    U1_Zero = (unsigned int)b;
    U1_Zero /= 33;                               //3%
    U1_Rl -= U1_Zero;                            //97% (for resistors near 1k)
    //Resistor
    if ((U2_Rl >= U1_Rl) && (U2_Rl <= U1_Rh)) return;     
  }
  //If U_Rl (Vf) is between 0.15V and 4.64V it's a diode
  if ((U2_Rl > 150) && (U2_Rl < 4640))
  {
    //If we haven't found any other component yet
    if ((Check.Found == COMP_NONE) ||
        (Check.Found == COMP_RESISTOR))
    {
      Check.Found = COMP_DIODE;
    }
    //Save data
    Diode = &Diodes[Check.Diodes];
    Diode->A = Probes.Pin_1;
    Diode->C = Probes.Pin_2;
    Diode->V_f = U2_Rl;                          //Vf for high measurement current
    Diode->V_f2 = U2_Rh;                         //Vf for low measurement current
    Check.Diodes++;
  }
}

//Verify MOSFET by checking the body diode
void VerifyMOSFET(void)
{
  byte                        Flag = 0;
  byte                        n = 0;
  byte                        Anode;
  byte                        Cathode;
  Diode_Type                  *Diode;            //Pointer to diode
  //Set expected body diode
  if (Check.Type & TYPE_N_CHANNEL)               //n-channel
  {
    Anode = FET.S;
    Cathode = FET.D;
  }
  else                                           //p-channel
  {
    Anode = FET.D;
    Cathode = FET.S;
  }
  Diode = &Diodes[0];                            //First diode
  //Check all known diodes for reversed one
  while (n < Check.Diodes)
  {
    if ((Diode->A == Cathode) && (Diode->C == Anode))
    {
      Flag = 1;                                  //Signal match
      n = 10;                                    //End loop
    }
    n++;                                         //Next diode
    Diode++;
  }
  if (Flag == 1)                                 //Found reversed diode
  {
    //This can't be a MOSFET, so let's reset
    Check.Found = COMP_NONE;
    Check.Type = 0;
    Check.Done = 0;
  }
}

//Check for BJT or enhancement-mode MOSFET
void CheckBJTorEnhModeMOSFET(byte BJT_Type, unsigned int U_Rl)
{
  byte                        FET_Type;          //MOSFET type 
  unsigned int                U_R_c;             //Voltage across collector resistor 
  unsigned int                U_R_b;             //Voltage across base resistor 
  unsigned int                BJT_Level;         //Voltage threshold for BJT 
  unsigned int                FET_Level;         //Voltage threshold for FET 
  unsigned int                I_CE0;             //Leakage current 
  unsigned long               hFE_C;             //hFE (common collector) 
  unsigned long               hFE_E;             //hFE (common emitter) 
  //Init, set probes and measure
  if (BJT_Type == TYPE_NPN)                      //NPN / n-channel
  {
    BJT_Level = 2557;                            //Voltage across base resistor (5.44ÂµA)
    FET_Level = 3400;                            //Voltage across drain resistor (4.8mA) 
    FET_Type = TYPE_N_CHANNEL;
    /*
       We assume
        - BJT: probe-1 = C / probe-2 = E / probe-3 = B
        - FET: probe-1 = D / probe-2 = S / probe-3 = G
        probes already set to: Gnd -- probe-2 / probe-1 -- Rl -- Vcc
        drive base/gate via Rh instead of Rl
    */
    R_DDR = Probes.Rl_1 | Probes.Rh_3;           //Enable Rl for probe-1 & Rh for probe-3
    R_PORT = Probes.Rl_1 | Probes.Rh_3;          //Pull up collector via Rl and base via Rh
    delay(50);                                   //Wait to skip gate charging of a FET
    U_R_c = UREF_VCC - ReadU(Probes.Pin_1);      //U_R_c = Vcc - U_c 
    U_R_b = UREF_VCC - ReadU(Probes.Pin_3);      //U_R_b = Vcc - U_b 
  }
  else                                           //PNP / p-channel
  {
    BJT_Level = 977;                             //Voltage across base resistor (2.1ÂµA) 
    FET_Level = 2000;                            //Voltage across drain resistor (2.8mA) 
    FET_Type = TYPE_P_CHANNEL;
    /*
       We assume
        - BJT: probe-1 = E / probe-2 = C / probe-3 = B
        - FET: probe-1 = S / probe-2 = D / probe-3 = G
        probes already set to: Gnd -- Rl - probe-2 / probe-1 -- Vcc
        drive base/gate via Rh instead of Rl
    */
    R_DDR = Probes.Rl_2 | Probes.Rh_3;           //Pull down base via Rh
    U_R_c = ReadU_5ms(Probes.Pin_2);             //U_R_c = U_c
    U_R_b = ReadU(Probes.Pin_3);                 //U_R_b = U_b
  }
  //Distinguish BJT from depletion-mode MOSFET
  if (U_R_b > BJT_Level)                         //U_R_b exceeds minimum level of BJT
  {
    /*
       A voltage drop across the base resistor Rh means that a current
       is flowing constantly. So this can't be a FET.
     
       Problem:
        A reversed collector and emitter also passes the tests, but with
        a low hFE. So we need to run two tests to be sure and select the
        test results with the higher hFE.
    */
    //Two test runs needed at maximium to get right hFE & pins
    if (Check.Found == COMP_BJT) Check.Done = 1;
    Check.Found = COMP_BJT;
    Check.Type = BJT_Type;
    //Leakage current
    I_CE0 = GetLeakageCurrent();                 //Get leakage current (in ÂµA)
    /*
       Calculate hFE via voltages and known resistors:
        - hFE = I_c / I_b
              = (U_R_c / R_c) / (U_R_b / R_b)
              = (U_R_c * R_b) / (U_R_b * R_c)
        - consider leakage current:
          I_c = I_c_conducting - I_c_leak
              = (U_R_c_conducting / R_c) - (U_R_c_leak / R_c)
              = (U_R_c_conducting - U_R_c_leak) / R_c
          -> U_R_c = U_R_c_conducting - U_R_c_leak
                   = U_R_c_conducting - U_Rl
    */
    if (U_R_c > U_Rl) U_R_c -= U_Rl;             // - U_Rl (leakage) 
    hFE_E = U_R_c * R_HIGH;                      //U_R_c * R_b 
    hFE_E /= U_R_b;                              // / U_R_b 
    hFE_E *= 10;                                 //Upscale to 0.1 
    if (BJT_Type == TYPE_NPN)                    //NPN
      hFE_E /= (R_LOW * 10) + Config.RiH;        // / R_c in 0.1 Ohm
    else                                         //PNP 
      hFE_E /= (R_LOW * 10) + Config.RiL;        // / R_c in 0.1 Ohm 
    //Get hFE for common collector circuit
    hFE_C = Get_hFE_C(BJT_Type);
    //Keep largest hFE
    if (hFE_C > hFE_E) hFE_E = hFE_C;
    //Only update data if hFE is larger than old one
    if (hFE_E > BJT.hFE)
    {
      //Save data
      BJT.hFE = hFE_E;
      BJT.I_CE0 = I_CE0;
      BJT.B = Probes.Pin_3;
      if (BJT_Type == TYPE_NPN)                  //NPN
      {
        BJT.C = Probes.Pin_1;
        BJT.E = Probes.Pin_2;
      }
      else                                       //PNP
      {
        BJT.C = Probes.Pin_2;
        BJT.E = Probes.Pin_1;
      }
    }
#if 0
    /*
       Check for proper emitter and collector:
        - I_c is much lower for reversed emitter and collector.
        - So we reverse the probes and measure I_c (= U_R_c / R_c) again.
        - Since R_c is constant we may simply compare U_R_c.
     
       This is an alternative solution instead of running the check two times.
    */
    SetADCHiz();                                 //Set ADC port to HiZ mode
    R_DDR = 0;                                   //Set resistor port to HiZ mode
    if (BJT_Type == TYPE_NPN)                    //NPN
    {
      //We assume: probe-1 = E / probe-2 = C / probe-3 = B, set probes: Gnd -- probe-1 / probe-2 -- Rl -- Vcc
      SetADCLow();
      SET_ADC_DDR(Probes.ADC_1);                    //Pull-down emitter directly 
      R_PORT = Probes.Rl_2 | Probes.Rh_3;        //Pull-up base via Rh 
      R_DDR = Probes.Rl_2 | Probes.Rh_3;         //Enable probe resistors 
      U_R_b = UREF_VCC - ReadU_5ms(Probes.Pin_2);//U_R_c = Vcc - U_c        
    }
    else                                         //PNP
    { 
      //We assume: probe-1 = C / probe-2 = E / probe-3 = B, set probes: Gnd -- Rl - probe-1 / probe-2 -- Vcc
      R_PORT = 0;
      R_DDR = Probes.Rl_1 | Probes.Rh_3;         //Pull down base via Rh
      SET_ADC_DDR(Probes.ADC_2);
      SET_ADC_PORT(Probes.ADC_2);                   //Pull-up emitter directly
      U_R_b = ReadU_5ms(Probes.Pin_1);           //U_R_c = U_c
    }
    //If not reversed, BJT is identified
    if (U_R_c > U_R_b)                           //I_c > I_c_reversed
    {
      //Move other stuff here: save data & Comp=
      Check.Done = 1;
    }
#endif
  }
  else if ((U_Rl < 97) && (U_R_c > FET_Level))   //No BJT
  {
    /*
       If there's
        - just a small leakage current (< 0.1mA) in non-conducting mode
        - a large U_R_c (= large current) when conducting
        - a low U_R_b (= very low gate current)
        we got a FET or an IGBT.
        The drain source channel of a MOSFET is modeled as a resistor
        while an IGBT acts more like a diode. So we measure the voltage drop
        across the conducting path. A MOSFET got a low voltage drop based on
        it's R_DS_on and the current. An IGBT got a much higher voltage drop.
    */
    I_CE0= ReadU(Probes.Pin_1) - ReadU(Probes.Pin_2);
    if (I_CE0 < 250)                             //MOSFET
    {
      Check.Found = COMP_FET;
      Check.Type = FET_Type | TYPE_ENHANCEMENT | TYPE_MOSFET;
    }
    else                                         //IGBT
    {
      Check.Found = COMP_IGBT;
      Check.Type = FET_Type | TYPE_ENHANCEMENT;
    }
    Check.Done = 1;                              //Transistor found
    //Measure gate threshold voltage
    GetGateThreshold(FET_Type);
    //Save data
    FET.G = Probes.Pin_3;
    if (FET_Type == TYPE_N_CHANNEL)              //n-channel
    {
      FET.D = Probes.Pin_1;
      FET.S = Probes.Pin_2;      
    }
    else                                         //p-channel
    {
      FET.D = Probes.Pin_2;
      FET.S = Probes.Pin_1;
    }
  }
}

//Check for a depletion mode FET (self conducting)
void CheckDepletionModeFET(unsigned int U_Rl_L)
{
  unsigned int                U_1;               //Voltage #1
  unsigned int                U_2;               //Voltage #2
  /*
     Required probe setup (by calling function):
      - Gnd -- Rl -- probe-2 / probe-1 -- Vcc
  
     Check if we got a n-channel JFET or depletion-mode MOSFET
      - JFETs are depletion-mode only
  */
  if (Check.Done == 0)                           //No transistor found yet
  {
    //We assume: probe-1 = D / probe-2 = S / probe-3 = G, probes already set to: Gnd -- Rl -- probe-2 / probe-1 -- Vcc
    R_DDR = Probes.Rl_2 | Probes.Rh_3;           //Pull down gate via Rh
    U_1 = ReadU_20ms(Probes.Pin_2);              //Voltage at source 
    R_PORT = Probes.Rh_3;                        //Pull up gate via Rh
    U_2 = ReadU_20ms(Probes.Pin_2);              //Voltage at source
    /*
       If the source voltage is higher when the gate is driven by a positive
       voltage vs. connected to ground we got a depletion-mode n-channel FET.
       The source resistor creates a voltage offset based on the current
       causing V_GS to become negative with the gate pulled down.
    */
    if (U_2 > (U_1 + 488))
    {
      //Compare gate voltages to distinguish JFET from MOSFET
      //Set probes: Gnd -- probe-2 / probe-1 -- Rl -- Vcc
      SetADCLow();                               //Set ADC port to low
      SET_ADC_DDR(Probes.ADC_2);                    //Pull down source directly 
      R_DDR = Probes.Rl_1 | Probes.Rh_3;         //Enable Rl for probe-1 & Rh for probe-3 
      R_PORT = Probes.Rl_1 | Probes.Rh_3;        //Pull up drain via Rl / pull up gate via Rh 
      U_2 = ReadU_20ms(Probes.Pin_3);            //Get voltage at gate 
      if (U_2 > 3911)                            //MOSFET
      {
        //n channel depletion-mode MOSFET
        Check.Type = TYPE_N_CHANNEL | TYPE_DEPLETION | TYPE_MOSFET;
      }
      else                                       //JFET
      {
        //n channel JFET (depletion-mode only)
        Check.Type = TYPE_N_CHANNEL | TYPE_JFET;
      }
      //Save data
      Check.Found = COMP_FET;
      Check.Done = 1;
      FET.G = Probes.Pin_3;
      FET.D = Probes.Pin_1;
      FET.S = Probes.Pin_2;
    }
  }
  //Check if we got a p-channel JFET or depletion-mode MOSFET - JFETs are depletion-mode only
  if (Check.Done == 0)                           //No transistor found yet
  {
    //We assume: probe-1 = S / probe-2 = D / probe-3 = G, set probes: Gnd -- probe-2 / probe-1 -- Rl -- Vcc
    SetADCLow();                                 //Set ADC port to Gnd 
    SET_ADC_DDR(Probes.ADC_2);                      //Pull down drain directly 
    R_DDR = Probes.Rl_1 | Probes.Rh_3;           //Enable Rl for probe-1 & Rh for probe-3 
    R_PORT = Probes.Rl_1 | Probes.Rh_3;          //Pull up source via Rl / pull up gate via Rh 
    U_1 = ReadU_20ms(Probes.Pin_1);              //Get voltage at source 
    R_PORT = Probes.Rl_1;                        //Pull down gate via Rh 
    U_2 = ReadU_20ms(Probes.Pin_1);              //Get voltage at source 
    /*
       If the source voltage is higher when the gate is driven by a positive
       voltage vs. connected to ground we got a depletion-mode p-channel FET.
       The source resistor creates a voltage offset based on the current
       causing V_GS to become positive with the gate pulled up.
    */
    if (U_1 > (U_2 + 488))
    {
      //Compare gate voltages to distinguish JFET from MOSFET
      //Set probes: probe-2 = HiZ / probe-1 -- Vcc
      SET_ADC_PORT(Probes.ADC_1);                   //Pull up source directly
      SET_ADC_DDR(Probes.ADC_1);                    //Enable pull up for source
      //Gate is still pulled down via Rh
      U_2 = ReadU_20ms(Probes.Pin_3);            //Get voltage at gate
      if (U_2 < 977)                             //MOSFET
      {
        //p channel depletion-mode MOSFET
        Check.Type =  TYPE_P_CHANNEL | TYPE_DEPLETION | TYPE_MOSFET; 
      }
      else                                       //JFET
      {
        //p channel JFET (depletion-mode only)
        Check.Type = TYPE_P_CHANNEL | TYPE_DEPLETION | TYPE_JFET;
      }
      //Save data
      Check.Found = COMP_FET;
      Check.Done = 1;
      FET.G = Probes.Pin_3;
      FET.D = Probes.Pin_2;
      FET.S = Probes.Pin_1;
    }
  }
}

//Special devices
byte CheckThyristorTriac(void)
{
  byte                        Flag = 0;          //Return value 
  unsigned int                U_1;               //Voltage #1 
  unsigned int                U_2;               //Voltage #2 
  /*
     Check for a thyristor (SCR) or triac
      - A thyristor conducts also after the gate is discharged as long
        as the load current stays alive and doesn't reverse polarity.
      - A triac is a pair of anti-parallel thyristors. 
      - It's possible that the tester doesn't deliver enough current, so
        it can't detect all types.

      probes need to be set already to:
        Gnd -- probe-2 / probe-1 -- Rl -- Vcc
  */
  //We assume: probe-1 = A / probe-2 = C / probe-3 = G, discharge gate
  PullProbe(Probes.Rl_3, FLAG_10MS | FLAG_PULLDOWN);    
  U_1 = ReadU_5ms(Probes.Pin_1);                 //Get voltage at anode
  R_PORT = 0;                                    //Pull down anode 
  delay(5);
  R_PORT = Probes.Rl_1;                          //And pull up anode again 
  U_2 = ReadU_5ms(Probes.Pin_1);                 //Get voltage at anode (below Rl)
  //Voltages match behaviour of thyristor or triac
  if ((U_1 < 1600) && (U_2 > 4400))
  {
    Check.Found = COMP_THYRISTOR;                //If not detected as a triac below
    Check.Done = 1;
    /*
       Check if we got a triac
        - reverse A and C (A = MT2 / C = MT1)
        - check if behaviour is the same
    */
    //We assume: probe-1 = MT2 / probe-2 = MT1 / probe-3 = G
    R_DDR = 0;                                   //Disable all probe resistors
    R_PORT = 0;
    SET_ADC_PORT(Probes.ADC_2);                     //Pull up MT1 directly
    delay(5);
    R_DDR = Probes.Rl_1;                         //Pull down MT2 via Rl
    //Probe-3/gate is in HiZ mode, triac shouldn't conduct without a triggered gate
    U_1 = ReadU_5ms(Probes.Pin_1);               //Get voltage at MT2
    //Voltage of MT2 is low (no current)
    if (U_1 <= 244)
    {
      //Trigger gate for reverse direction
      R_DDR = Probes.Rl_1 | Probes.Rl_3;         //And pull down gate via Rl 
      U_1 = ReadU_5ms(Probes.Pin_3);             //Get voltage at gate 
      U_2 = ReadU(Probes.Pin_1);                 //Get voltage at MT2 
      //Voltage at gate is ok and voltage at MT2 is high (current = triac is conducting)
      if ((U_1 >= 977) && (U_2 >= 733))
      {
        //Check if triac still conducts without triggered gate
        R_DDR = Probes.Rl_1;                     //Set probe3 to HiZ mode
        U_1 = ReadU_5ms(Probes.Pin_1);           //Get voltage at MT2 
        //Voltage at MT2 is still high (current = triac is conducting)
        if (U_1 >= 733)
        {
          //Check if triac stops conducting when load current drops to zero
          R_PORT = Probes.Rl_1;                  //Pull up MT2 via Rl 
          delay(5);
          R_PORT = 0;                            //And pull down MT2 via Rl 
          U_1 = ReadU_5ms(Probes.Pin_1);         //Get voltage at MT2 
          //Voltage at MT2 is low (no current = triac is not conducting)
          if (U_1 <= 244)
          {
            //Now we are pretty sure that the DUT is a triac
            Check.Found = COMP_TRIAC;
          }
        }
      }
    }
    //Save data (we misuse BJT)
    BJT.B = Probes.Pin_3;
    BJT.C = Probes.Pin_1;
    BJT.E = Probes.Pin_2;
    Flag = 1;                                    //Signal that we found a component
  }
  return Flag;
}

//Measure a resistor with low resistance (< 100 Ohms)
unsigned int SmallResistor(byte ZeroFlag)
{
  unsigned int                R = 0;             //Return value
  byte                        Probe;             //Probe ID 
  byte                        Mode;              //Measurement mode 
  byte                        Counter;           //Sample counter 
  unsigned long               Value;             //ADC sample value 
  unsigned long               Value1 = 0;        //U_Rl temp. value 
  unsigned long               Value2 = 0;        //U_R_i_L temp. value 
  DischargeProbes();                             //Try to discharge probes
  if (Check.Found == COMP_ERROR) return R;       //Skip on error
  /*
     Measurement method:
      - use Rl as current shunt
      - create a pulse and measure voltage at high side of DUT for 1000 times 
      - repeat that for the low side of the DUT
  */
  //Pulse on: GND -- probe 2 / probe 1 -- Rl -- 5V, pulse off: GND -- probe 2 / probe 1 -- Rl -- GND
  SetADCLow();                                   //Set ADC port to low 
  SET_ADC_DDR(Probes.ADC_2);                        //Pull-down probe 2 directly 
  R_PORT = 0;                                    //Low by default 
  R_DDR = Probes.Rl_1;                           //Enable resistor
  #define MODE_HIGH           0b00000001
  #define MODE_LOW            0b00000010
  //Measurement loop
  Mode = MODE_HIGH;
  while (Mode > 0)
  {
    //Setup measurement
    if (Mode & MODE_HIGH) Probe = Probes.Pin_1;
    else Probe = Probes.Pin_2;
    wdt_reset();                                 //Reset watchdog 
    Counter = 0;                                 //Reset loop counter 
    Value = 0;                                   //Reset sample value 
    //Set ADC to use bandgap reference and run a dummy conversion
    Probe |= (1 << REFS0) | (1 << REFS1);
    ADMUX = Probe;                               //Set input channel and U reference 
    waitus(100);                                 //Time for voltage stabilization 
    ADCSRA |= (1 << ADSC);                       //Start conversion 
    while (ADCSRA & (1 << ADSC));                //Wait until conversion is done 
    //Measurement loop (about 1ms per cycle)
    while (Counter < 100)
    {
      //Create short pulse
      SET_ADC_DDR(Probes.ADC_2);                    //Pull-down probe-2 directly
      R_PORT = Probes.Rl_1;
      //Start ADC conversion, ADC performs S&H after 1.5 ADC cycles (12Âµs)
      ADCSRA |= (1 << ADSC);                     //Start conversion
      //Wait 20Âµs to allow the ADC to do it's job
      waitus(20);
      //Stop pulse
      R_PORT = 0;
      SET_ADC_DDR(Probes.ADC_2 | Probes.ADC_1);
      //Get ADC reading (about 100Âµs)
      while (ADCSRA & (1 << ADSC));              //Wait until conversion is done 
      Value += ADCW;                             //Add ADC reading 
      //Wait
      waitus(900);
      Counter++;                                 //Next round
    }
    //Convert ADC reading to voltage
    Value *= Config.U_Bandgap;
    Value /= 1024;                               // / 1024 for 10bit ADC 
    Value /= 10;                                 //De-sample to 0.1mV 
    //Loop control
    if (Mode & MODE_HIGH)                        //Probe #1 / Rl
    {
      Mode = MODE_LOW;                           //Switch to low side
      Value1 = Value;                            //Save measured value 
    }
    else                                         //Probe #2 / R_i_L
    {
      Mode = 0;                                  //End loop 
      Value2 = Value;                            //Save measured value
    }
  }
  //Process measurement
  if (Value1 > Value2)                           //Sanity check
  {
    //I = U/R = (5V - U_Rl)/(Rl + R_i_H)
    Value = 10UL * UREF_VCC;                     //in 0.1 mV
    Value -= Value1;
    Value *= 1000;                               //Scale to ÂµA 
    Value /= ((R_LOW * 10) + Config.RiH);        //in 0.1 Ohms 
    Value1 -= Value2;                            //in 0.1 mV 
    Value1 *= 10000;                             //Scale to 0.01 ÂµV
    //R = U/I (including R of probe leads)
    Value1 /= Value;                             //in 0.01 Ohms
    R = (unsigned int)Value1;                    //Copy result 
    if (ZeroFlag == 1)                           //Auto-zero
    {
      if (R > Config.RZero) R -= Config.RZero;
      else R = 0;
    }
  }
#undef                        MODE_LOW
#undef                        MODE_HIGH
  //Update Uref flag for next ADC run
  Config.RefFlag = (1 << REFS1);                 //Set REFS1 bit flag
  return R;
}

//Check for resistor
void CheckResistor(void)
{
  Resistor_Type               *Resistor;         //Pointer to resistor 
  unsigned long               Value1;            //Resistance of measurement #1 
  unsigned long               Value2;            //Resistance of measurement #2 
  unsigned long               Value;             //Resistance value 
  unsigned long               Temp;              //Temp. value 
  signed char                 Scale;             //Resistance scale 
  signed char                 Scale2;            //Resistance scale 
  byte                        n;                 //Counter 
  //Voltages
  unsigned int                U_Rl_H;            //Voltage #1 
  unsigned int                U_Ri_L;            //Voltage #2 
  unsigned int                U_Rl_L;            //Voltage #3 
  unsigned int                U_Ri_H;            //Voltage #4 
  unsigned int                U_Rh_H;            //Voltage #5 
  unsigned int                U_Rh_L;            //Voltage #6 
  wdt_reset();                                   //Reset watchdog
  /*
     Resistor measurement
      - Set up a voltage divider with well known probe resistors and
        measure the voltage at the DUT.
      - For low resistance consider the internal resistors of the ÂµC
        for pulling up/down.
      - Calculate resistance via the total current and the voltage
        at the DUT.
      - We could also use the voltage divider rule:
        (Ra / Rb) = (Ua / Ub) -> Ra = Rb * (Ua / Ub)
   
     check if we got a resistor
      - A resistor has the same resistance in both directions.
      - We measure both directions with both probe resistors.
  */
  //We assume: resistor between probe-1 and probe-2, set probes: Gnd -- probe-2 / probe-1 -- Rl -- Vcc
  SetADCLow();                                   //Set ADC port low low 
  SET_ADC_DDR(Probes.ADC_2);                        //Pull down probe-2 directly 
  R_DDR = Probes.Rl_1;                           //Enable Rl for probe-1 
  R_PORT = Probes.Rl_1;                          //Pull up probe-1 via Rl 
  U_Ri_L = ReadU_5ms(Probes.Pin_2);              //Get voltage at internal R of ÂµC 
  U_Rl_H = ReadU(Probes.Pin_1);                  //Get voltage at Rl pulled up 
  /*
     Check for a capacitor
      - A capacitor would need some time to discharge.
      - So we pull down probe-1 via Rh and measure the voltage.
      - The voltage will drop immediately for a resistor.
  */
  //Set probes: Gnd -- probe-2 / Gnd -- Rh -- probe-1
  R_PORT = 0;                                    //Set resistor port low 
  R_DDR = Probes.Rh_1;                           //Pull down probe-1 via Rh 
  U_Rh_L = ReadU_5ms(Probes.Pin_1);              //Get voltage at probe 1 
  //We got a resistor if the voltage is near Gnd
  if (U_Rh_L <= 20)
  {
    //Set probes: Gnd -- probe-2 / probe-1 -- Rh -- Vcc
    R_PORT = Probes.Rh_1;                        //Pull up probe-1 via Rh 
    U_Rh_H = ReadU_5ms(Probes.Pin_1);            //Get voltage at Rh pulled up 
    //Set probes: Gnd -- Rl -- probe-2 / probe-1 -- Vcc
    SET_ADC_DDR(Probes.ADC_1);                      //Set probe-1 to output 
    SET_ADC_PORT(Probes.ADC_1);                     //Pull up probe-1 directly 
    R_PORT = 0;                                  //Set resistor port to low 
    R_DDR = Probes.Rl_2;                         //Pull down probe-2 via Rl 
    U_Ri_H = ReadU_5ms(Probes.Pin_1);            //Get voltage at internal R of ÂµC 
    U_Rl_L = ReadU(Probes.Pin_2);                //Get voltage at Rl pulled down 
    //Set probes: Gnd -- Rh -- probe-2 / probe-1 -- Vcc
    R_DDR = Probes.Rh_2;                         //Pull down probe-2 via Rh 
    U_Rh_L = ReadU_5ms(Probes.Pin_2);            //Get voltage at Rh pulled down 
    //If voltage breakdown is sufficient 
    if ((U_Rl_H >= 4400) || (U_Rh_H <= 97))      //R >= 5.1k / R < 9.3k 
    {
      if (U_Rh_H < 4972)                         //R < 83.4M & prevent division by zero 
      {
        //Voltage breaks down with low test current and it is not nearly shorted => resistor
        Value = 0;                               //Reset value of resistor 
        if (U_Rl_L < 169)                        //R > 19.5k 
        {
          //Use measurements done with Rh, resistor is less 60MOhm
          if (U_Rh_L >= 38)                      //R < 61.4M & prevent division by zero
          {
            /*
               Rh pulled up (above DUT):
               I = U_Rh / Rh = (Vcc - U_Rh_H) / Rh
               R = U_R / I = U_Rh_H / ((Vcc - U_Rh_H) / Rh)
                 = Rh * U_Rh_H / (Vcc - U_Rh_H)
             
               Or via voltage divider:
               R = Rh * (U_dut / U_Rh)
                 = Rh * (U_Rh_H / (Vcc - U_Rh_H))
            */
            Value1 = R_HIGH * U_Rh_H;
            Value1 /= (UREF_VCC - U_Rh_H);
            /*
               Rh pulled down (below DUT):
               I = U_Rh_L / Rh
               R = U_R / I = (Vcc - U_Rh_L) / (U_Rh_L / Rh)
                 = Rh * (Vcc - U_Rh_L) / U_Rh_L
             
               Or via voltage divider:
               R = Rh * (U_R / U_Rh)
                 = Rh * ((Vcc - U_Rh_L) / U_Rh_L)
            */
            Value2 = R_HIGH * (UREF_VCC - U_Rh_L);
            Value2 /= U_Rh_L;
            /*
               Calculate weighted average of both measurements
                - Voltages below the bandgap reference got a higher resolution
                  (1.1mV instead of 4.9mV).
            */
            if (U_Rh_H < 990)                    //Below bandgap reference
            {
              //Weighted average for U_Rh_H
              Value = (Value1 * 4);
              Value += Value2;
              Value /= 5;
            }
            else if (U_Rh_L < 990)               //Below bandgap reference
            {
              //Weighted average for U_Rh_L 
              Value = (Value2 * 4);
              Value += Value1;
              Value /= 5;
            }
            else                                 //Higher than bandgap reference
            {
              //Classic average
              Value = (Value1 + Value2) / 2;
            }
            Value += RH_OFFSET;                  //Add offset value for Rh
            Value *= 10;                         //Upscale to 0.1 Ohms
          }
        }
        else                                     //U_Rl_L: R <= 19.5k
        {
          //Use measurements done with Rl
          //Voltages below and above DUT match voltage divider 
          //Voltage below DUT can't be higher than above DUT 
          if ((U_Rl_H >= U_Ri_L) && (U_Ri_H >= U_Rl_L))
          {
            /*
               Rl pulled up (above DUT):
               I = U_Rl_RiH / (Rl + RiH) = (Vcc - U_Rl_H) / (Rl + RiH)
               R = U_Dut / I
                 = (U_Rl_H - U_Ri_L) / ((Vcc - U_Rl_H) / (Rl + RiH))
                 = (Rl + RiH) * (U_Rl_H - U_Ri_L) / (Vcc - U_Rl_H)
             
               Or via voltage divider:
               R = (Rl + RiH) * (U_R_RiL / U_Rl_RiH) - RiL
                 = (Rl + RiH) * (U_R_RiL / (Vcc - U_dut_RiL)) - RiL
            */
            //Prevent division by zero
            if (U_Rl_H == UREF_VCC) U_Rl_H = UREF_VCC - 1;   
            Value1 = (R_LOW * 10) + Config.RiH;  //Rl + RiH in 0.1 Ohm
            Value1 *= (U_Rl_H - U_Ri_L);
            Value1 /= (UREF_VCC - U_Rl_H);
            /*
               Rl pulled down (below DUT):
               I = U_Rl_RiL / (Rl + RiL)
               R = U_R / I
                 = (U_Ri_H - U_Rl_L) / (U_Rl_RiL / (Rl + RiL))
                 = (Rl + RiL) * (U_Ri_H - U_Rl_L) / U_Rl_RiL
             
               Or via voltage divider:
               R = (Rl + RiL) * (U_R_RiH / U_Rl_RiL) - RiH
                 = (Rl + RiL) * ((Vcc - U_Rl_RiL) / U_Rl_RiL) - RiH
            */
            Value2 = (R_LOW * 10) + Config.RiL;  //Rl + RiL in 0.1 Ohms
            Value2 *= (U_Ri_H - U_Rl_L);
            Value2 /= U_Rl_L;
            /*
               Calculate weighted average of both measurements
                - Voltages below the bandgap reference got a higher resolution
                  (1.1mV instead of 4.9mV).
            */
            if (U_Rl_H < 990)                    //Below bandgap reference
            {
              //Weighted average for U_Rh_H
              Value = (Value1 * 4);
              Value += Value2;
              Value /= 5;
            }
            else if (U_Rl_L < 990)               //Below bandgap reference
            {
              //Weighted average for U_Rh_L
              Value = (Value2 * 4);
              Value += Value1;
              Value /= 5;
            }
            else                                 //Higher than bandgap reference
            {
              //Classic average
              Value = (Value1 + Value2) / 2;
            }
          }
          else                                   //May happen for very low resistances
          {
            if (U_Rl_L > 4750) Value = 1;        //U_Rl_L: R < 15 Ohms
            //This will trigger the low resistance measurement below
          }
        }
        //Process results of the resistance measurement
        if (Value > 0)                           //Valid resistor
        {
          Scale = -1;                            //0.1 Ohm by default
          //Meassure small resistor <10 Ohm with special method
          if (Value < 100UL)
          {
            //Run low resistance measurement
            Value2 = (unsigned long)SmallResistor(1);
            Scale2 = -2;                         //0.01 Ohm
            //Check for valid result
            Value1 = Value * 2;                  //Allow 100% tolerance       
            Value1 *= 10;                        //Re-scale to 0.01 Ohms    
            if (Value1 > Value2)                 //Got expected value
            {
              Value = Value2;                    //Update data
              Scale = Scale2;
            }
          }
          //Check for measurement in reversed direction
          n = 0;
          while (n < Check.Resistors)            //Loop through resistors
          {
            Resistor = &Resistors[n];            //Pointer to element
            if ((Resistor->A == Probes.Pin_1) && (Resistor->B == Probes.Pin_2))
            {
              //Check if the reversed measurement is within a specific tolerance
              //Set lower and upper tolerance limits 
              //< 2 Ohm 
              if (CmpValue(Value, Scale, 2, 0) == -1) 
              {
                Temp = Value / 2;                //50%
              }
              else                               //>= 2 Ohm
              {
                Temp = Value / 20;               //5%
              }
              Value1 = Value - Temp;             //95% or 50% 
              Value2 = Value + Temp;             //105% or 150% 
              //Special case for very low resistance 
              //< 0.1 Ohm
              if (CmpValue(Value, Scale, 1, -1) == -1)   
              {
                Value1 = 0;                      //0
                Value2 = Value * 5;              //500%
                if (Value2 == 0) Value2 = 5;     //Special case
              }
              //Check if value matches given tolerance
              if ((CmpValue(Resistor->Value, Resistor->Scale, Value1, Scale) >= 0) &&
                  (CmpValue(Resistor->Value, Resistor->Scale, Value2, Scale) <= 0))
              {
                Check.Found = COMP_RESISTOR;
                n = 100;                         //End loop and signal match
              }
              else                               //No match
              {
                n = 200;                         //End loop and signal mis-match
              }
            }
            else                                 //No match 
            {
              n++;                               //Next one 
            }
          }
          //We got a new resistor
          if (n != 100)                          //Not a known resistor
          {
            if (Check.Resistors < 3)             //Prevent array overflow
            {
              //Save data
              //Unused dataset
              Resistor = &Resistors[Check.Resistors]; 
              Resistor->A = Probes.Pin_2;
              Resistor->B = Probes.Pin_1;
              Resistor->Value = Value;
              Resistor->Scale = Scale;
              Check.Resistors++;                 //Another one found
            }
          }
        }
      }
    }
  }
}

//Compare two scaled values
signed char CmpValue(unsigned long Value1, signed char Scale1, unsigned long Value2, signed char Scale2)
{
  signed char                 Flag;              //Return value
  signed char                 Len1, Len2;        //Length
  //Determine virtual length
  Len1 = NumberOfDigits(Value1) + Scale1;
  Len2 = NumberOfDigits(Value2) + Scale2;
  if ((Value1 == 0) || (Value2 == 0))            //Special case
  {
    Flag = 10;                                   //Perform direct comparison 
  }
  else if (Len1 > Len2)                          //More digits -> larger 
  {
    Flag = 1;
  }
  else if (Len1 == Len2)                         //Same length
  {
    //Re-scale to longer value
    Len1 -= Scale1;
    Len2 -= Scale2;
    while (Len1 > Len2)                          //Up-scale Value #2
    {
      Value2 *= 10;
      Len2++;
    }
    while (Len2 > Len1)                          //Up-scale Value #1
    {
      Value1 *= 10;
      Len1++;
    }   
    Flag = 10;                                   //Perform direct comparison
  }
  else                                           //Less digits -> smaller 
  {
    Flag = -1;
  }

  if (Flag == 10)                                //Perform direct comparison
  {
    if (Value1 > Value2) Flag = 1;
    else if (Value1 < Value2) Flag = -1;
    else Flag = 0;
  }
  return Flag;
}

//Get number of digits of a value
byte NumberOfDigits(unsigned long Value)
{
  byte                        Counter = 1;
  while (Value >= 10)
  {
    Value /= 10;
    Counter++;
  }
  return Counter;
}

//Measure cap >4.7ÂµF between two probe pins
byte LargeCap(Capacitor_Type *Cap)
{
  byte                        Flag = 3;          //Return value 
  byte                        TempByte;          //Temp. value 
  byte                        Mode;              //Measurement mode 
  signed char                 Scale;             //Capacitance scale 
  unsigned int                TempInt;           //Temp. value 
  unsigned int                Pulses;            //Number of charging pulses 
  unsigned int                U_Zero;            //Voltage before charging 
  unsigned int                U_Cap;             //Voltage of DUT 
  unsigned int                U_Drop = 0;        //Voltage drop 
  unsigned long               Raw;               //Raw capacitance value 
  unsigned long               Value;             //Corrected capacitance value 
  boolean                     rerun;
  //Setup mode
  Mode = FLAG_10MS | FLAG_PULLUP;                //Start with large caps
  do { 
    rerun = false;                               //One-Time
    /*
       We charge the DUT with up to 500 pulses each 10ms long until the
       DUT reaches 300mV. The charging is done via Rl. This method is
       suitable for large capacitances from 47uF up to 100mF. If we find a 
       lower capacitance we'll switch to 1ms charging pulses and try again
       (4.7ÂµF up to 47ÂµF).
     
       Problem:
        ReadADC() needs about 5ms (44 runs). We charge the DUT for 10ms and
        measure for 5ms. During that time the voltage will drop due to
        resistive losses of the DUT and the measurement itself. So the DUT
        seems to need more time to reach 300mV causing a higher capacitance
        be calculated.
     
       Remark:
        The Analog Input Resistance of the ADC is 100MOhm typically.
    */
    //Prepare probes
    DischargeProbes();                             //Try to discharge probes
    if (Check.Found == COMP_ERROR) return 0;       //Skip on error
    //Setup probes: Gnd -- probe 1 / probe 2 -- Rl -- Vcc 
    SetADCLow();                                   //Set ADC port to low 
    SET_ADC_DDR(Probes.ADC_2);                        //Pull-down probe 2 directly 
    R_PORT = 0;                                    //Set resistor port to low 
    R_DDR = 0;                                     //Set resistor port to HiZ 
    U_Zero = ReadU(Probes.Pin_1);                  //Get zero voltage (noise) 
    //Charge DUT with up to 500 pulses until it reaches 300mV 
    Pulses = 0;
    TempByte = 1;
    while (TempByte)
    {
      Pulses++;
      PullProbe(Probes.Rl_1, Mode);                //Charging pulse 
      U_Cap = ReadU(Probes.Pin_1);                 //Get voltage 
      U_Cap -= U_Zero;                             //Zero offset 
      //End loop if charging is too slow 
      if ((Pulses == 126) && (U_Cap < 75)) TempByte = 0;
      //End loop if 300mV are reached 
      if (U_Cap >= 300) TempByte = 0;
      //End loop if maximum pulses are reached 
      if (Pulses == 500) TempByte = 0;
      wdt_reset();                                 //Reset watchdog
    }
    //If 300mV are not reached DUT isn't a cap or much too large (>100mF) we can ignore that for mid-sized caps
    if (U_Cap < 300)
    {
      Flag = 1;
    }
    //If 1300mV are reached with one pulse we got a small cap
    if ((Pulses == 1) && (U_Cap > 1300))
    {
      if (Mode & FLAG_10MS)                        //<47ÂµF 
      {
        Mode = FLAG_1MS | FLAG_PULLUP;             //Set mode (1ms charging pulses) 
        rerun = true;                              //And re-run 
      }
      else                                         //<4.7ÂµF 
      {
        Flag = 2;
      }
    }
  } while (rerun);
  /*
     Check if DUT sustains the charge and get the voltage drop
      - run the same time as before minus the 10ms charging time
      - this gives us the approximation of the self-discharging
  */
  if (Flag == 3)
  {
    //Check self-discharging
    TempInt = Pulses;
    while (TempInt > 0)
    {
      TempInt--;                                 //Descrease timeout 
      U_Drop = ReadU(Probes.Pin_1);              //Get voltage 
      U_Drop -= U_Zero;                          //Zero offset 
      wdt_reset();                               //Reset watchdog 
    }
    //Calculate voltage drop
    if (U_Cap > U_Drop) U_Drop = U_Cap - U_Drop;
    else U_Drop = 0;
    //If voltage drop is too large consider DUT not to be a cap
    if (U_Drop > 100) Flag = 0;
  }
  /*
     Calculate capacitance
      - use factor from pre-calculated LargeCap_table
      - ignore Config.CapZero since it's in the pF range
  */
  if (Flag == 3)
  {
    Scale = -9;                                  //Factor is scaled to nF
    //Get interpolated factor from table 
    Raw = GetFactor(U_Cap + U_Drop, TABLE_LARGE_CAP);
    Raw *= Pulses;                               //C = pulses * factor 
    if (Mode & FLAG_10MS) Raw *= 10;             // *10 for 10ms charging pulses 
    if (Raw > UINT32_MAX / 1000)                 //Scale down if C >4.3mF 
    {
      Raw /= 1000;                               //Scale down by 10^3 
      Scale += 3;                                //Add 3 to the exponent 
    }
    Value = Raw;                                 //Copy raw value 
    //It seems that we got a systematic error
    Value *= 100;
    if (Mode & FLAG_10MS) Value /= 109;          //-9% for large cap 
    else Value /= 104;                           //-4% for mid cap 
    //Copy data
    Cap->A = Probes.Pin_2;                       //Pull-down probe pin 
    Cap->B = Probes.Pin_1;                       //Pull-up probe pin 
    Cap->Scale = Scale;                          //-9 or -6 
    Cap->Raw = Raw;
    Cap->Value = Value;                          //Max. 4.3*10^6nF or 100*10^3ÂµF
  }
  return Flag;
}
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
