jsc69/ComponentTester/software/ComponentTester-1.56m/ILI9163.h

/* ************************************************************************
 *
 *   ILI9163 color graphic display controller
 *
 *   (c) 2017-2025 by Markus Reschke
 *
 * ************************************************************************ */


/* ************************************************************************
 *   commands
 * ************************************************************************ */


/*
 *  no operation
 *  - 1 byte cmd
 */

#define CMD_NOP               0b00000000     /* no operation */


/*
 *  software reset
 *  - 1 byte cmd
 */

#define CMD_RESET             0b00000001     /* software reset */


/*
 *  read display identification information
 *  - 1 byte cmd + 4 bytes data (read mode)
 */

#define CMD_READ_DISP_ID      0b00000100     /* read display ID */

/* data byte #1: dummy byte */
/* data byte #2: manufacturer ID (0x54) */
/* data byte #3: module/driver version ID (0x80) */
/* data byte #4: module/driver version ID (0x66) */


/*
 *  read display status
 *  - 1 byte cmd + 5 bytes data (read mode)
 */

#define CMD_READ_STATUS       0b00001001     /* read display status */

/* data byte #1: dummy data */

/* data byte #2: status */
  /* horizontal refresh (horizontal order): */
#define FLAG_STAT_HOR_NORM    0b00000000     /* increment, left to right */
#define FLAG_STAT_HOR_REV     0b00000010     /* decrement, right to left */
  /* RGB/BGR order */
#define FLAG_STAT_COLOR_RGB   0b00000000     /* RGB */
#define FLAG_STAT_COLOR_BGR   0b00000100     /* BGR */
  /* vertical refresh (scan address order): */
#define FLAG_STAT_VER_NORM    0b00000000     /* increment, top to bottom */
#define FLAG_STAT_VER_REV     0b00001000     /* decrement, bottom to top */
  /* row/column exchange: */
#define FLAG_STAT_XY_NORM     0b00000000     /* normal */
#define FLAG_STAT_XY_REV      0b00010000     /* rreversed (X & Y swapped) */
  /* column address order: */
#define FLAG_STAT_COL_NORM    0b00000000     /* increment, left to right */
#define FLAG_STAT_COL_REV     0b00100000     /* decrement, right to left */
  /* row address order: */
#define FLAG_STAT_ROW_NORM    0b00000000     /* increment, top to bottom */
#define FLAG_STAT_ROW_REV     0b01000000     /* decrement, bottom to top */
  /* booster voltage: */
#define FLAG_STAT_BOOST_OFF   0b00000000     /* booster on */
#define FLAG_STAT_BOOST_ON    0b10000000     /* booster off */

/* data byte #3: status */
  /* display normal mode: */
#define FLAG_STAT_NORM_OFF    0b00000000     /* off */
#define FLAG_STAT_NORM_ON     0b00000001     /* on */
  /* sleep mode: */
#define FLAG_STAT_SLEEP_OFF   0b00000000     /* off */
#define FLAG_STAT_SLEEP_ON    0b00000010     /* on */
  /* partial mode: */
#define FLAG_STAT_PART_OFF    0b00000000     /* off */
#define FLAG_STAT_PART_ON     0b00000100     /* on */
  /* idle mode: */
#define FLAG_STAT_IDLE_OFF    0b00000000     /* off */
#define FLAG_STAT_IDLE_ON     0b00001000     /* on */
  /* interface color pixel format: */
#define FLAG_STAT_PIX_12      0b00110000     /* 12 bits per pixel */
#define FLAG_STAT_PIX_16      0b01010000     /* 16 bits per pixel */
#define FLAG_STAT_PIX_18      0b01100000     /* 18 bits per pixel */

/* data byte #4: status */
  /* gamma curve - bit 2: bit 0 (always 0) */
  /* tearing effect line: */
#define FLAG_STAT_TEAR_OFF    0b00000000     /* off */
#define FLAG_STAT_TEAR_ON     0b00000010     /* on */
  /* display: */
#define FLAG_STAT_DISP_OFF    0b00000000     /* off */
#define FLAG_STAT_DISP_ON     0b00000100     /* on */
  /* inversion: */
#define FLAG_STAT_INV_OFF     0b00000000     /* off */
#define FLAG_STAT_INV_ON      0b00100000     /* on */
  /* vertical scrolling: */
#define FLAG_STAT_VSCROLL_OFF 0b00000000     /* off */
#define FLAG_STAT_VSCROLL_ON  0b10000000     /* on */

/* data byte #5: status */
  /* tearing effect line mode: */
#define FLAG_STAT_TEAR_MODE1  0b00000000     /* mode 1: V-blanking */
#define FLAG_STAT_TEAR_MODE2  0b00100000     /* mode 2: V-blanking and H-blanking */
  /* gamma curve - bits 1 and 0: */
#define FLAG_STAT_GAMMA1      0b00000000     /* gamma curve 1 */
#define FLAG_STAT_GAMMA2      0b01000000     /* gamma curve 2 */
#define FLAG_STAT_GAMMA3      0b10000000     /* gamma curve 3 */
#define FLAG_STAT_GAMMA4      0b11000000     /* gamma curve 4 */


/*
 *  read display power mode
 *  - 1 byte cmd + 2 bytes data (read mode)
 */

#define CMD_READ_PWR_MODE     0b00001010     /* read display power mode */

/* data byte #1: dummy data */

/* data byte #2: status */
  /* display: */
#define FLAG_DISPLAY_OFF      0b00000000     /* off */
#define FLAG_DISPLAY_ON       0b00000100     /* on */
  /* display normal mode: */
#define FLAG_NORMAL_OFF       0b00000000     /* off (partial display) */
#define FLAG_NORMAL_ON        0b00001000     /* on (normal display) */
  /* sleep mode: */
#define FLAG_SLEEP_OFF        0b00000000     /* off (sleep in) */
#define FLAG_SLEEP_ON         0b00010000     /* on (sleep out) */
  /* partial mode: */
#define FLAG_PARTIAL_OFF      0b00000000     /* off */
#define FLAG_PARTIAL_ON       0b00100000     /* on */
  /* idle mode: */
#define FLAG_IDLE_OFF         0b00000000     /* off */
#define FLAG_IDLE_ON          0b01000000     /* on */
  /* booster voltage: */
#define FLAG_BOOSTER_OFF      0b00000000     /* off */
#define FLAG_BOOSTER_ON       0b10000000     /* on */


/*
 *  read display MADCTL (memory acccess control)
 *  - 1 byte cmd + 2 bytes data (read mode)
 */

#define CMD_READ_MADCTL       0b00001011     /* read display MADCTL */

/* data byte #1: dummy data */

/* data byte #2: status */
/* same as byte #1 of CMD_MEM_CTRL */
  /* horizontal refereshing direction: */
#define RFLAG_HREFRESH_NORM   0b00000000     /* left to right */
#define RFLAG_HREFRESH_REV    0b00000100     /* right to left */
  /* color order: */
#define RFLAG_COLOR_RGB       0b00000000     /* RGB color filter */
#define RFLAG_COLOR_BGR       0b00001000     /* BGR color filter */
  /* vertical refereshing direction: */
#define RFLAG_VREFRESH_NORM   0b00000000     /* top to bottom */
#define RFLAG_VREFRESH_REV    0b00010000     /* bottom to top */
  /* row/column exchange (MCU to memory): */
#define RFLAG_XY_NORM         0b00000000     /* normal */
#define RFLAG_XY_REV          0b00100000     /* reversed (X & Y swapped) */
  /* column address direction (MCU to memory): */
#define RFLAG_COL_NORM        0b00000000     /* left to right */
#define RFLAG_COL_REV         0b01000000     /* right to left */
  /* row address direction (MCU to memory): */
#define RFLAG_ROW_NORM        0b00000000     /* top to bottom */
#define RFLAG_ROW_REV         0b10000000     /* bottom to top */


/*
 *  read display pixel format
 *  - 1 byte cmd + 2 bytes data (read mode)
 */

#define CMD_READ_PIX_FORMAT   0b00001100     /* read display pixel format */

/* data byte #1: dummy data */

/* data byte #2: status */
/* same as byte #1 of CMD_PIX_FORMAT */
  /* MCU interface color format: */
#define RFLAG_IFPF_12         0b00000011     /* 12 bits per pixel */
#define RFLAG_IFPF_16         0b00000101     /* 16 bits per pixel */
#define RFLAG_IFPF_18         0b00000110     /* 18 bits per pixel */


/*
 *  read display image mode
 *  - 1 byte cmd + 2 bytes data (read mode)
 */

#define CMD_READ_IMG_MODE     0b00001101     /* read display image mode */

/* data byte #1: dummy data */

/* data byte #2: status */
  /* gamma curve */
#define FLAG_IMG_GAMMA1       0b00000000     /* gamma curve 1 */
#define FLAG_IMG_GAMMA2       0b00000001     /* gamma curve 2 */
#define FLAG_IMG_GAMMA3       0b00000010     /* gamma curve 3 */
#define FLAG_IMG_GAMMA4       0b00000011     /* gamma curve 4 */
  /* inversion */
#define FLAG_IMG_INV_OFF      0b00000000     /* off */
#define FLAG_IMG_INV_ON       0b00100000     /* on */
  /* vertical scrolling: */
#define FLAG_IMG_VSCROLL_OFF  0b00000000     /* off */
#define FLAG_IMG_VSCROLL_ON   0b10000000     /* on */


/*
 *  read display signal mode
 *  - 1 byte cmd + 2 bytes data (read mode)
 */

#define CMD_READ_SIG_MODE     0b00001110     /* read display signal mode */

/* data byte #1: dummy data */

/* data byte #2: mode flags */
  /* tearing effect line mode: */
#define FLAG_SIG_TEAR_1       0b00000000     /* mode 1 */
#define FLAG_SIG_TEAR_2       0b01000000     /* mode 2 */
  /* tearing effect line: */
#define FLAG_SIG_TEAR_OFF     0b00000000     /* off */
#define FLAG_SIG_TEAR_ON      0b10000000     /* on */


/*
 *  read peripheral self-diagnostic result
 *  - 1 byte cmd + 2 bytes data (read mode)
 */
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
