jsc69/ComponentTester/(commit log)

2025-09-21 use ADC6 + ADC7
    [ComponentTester.kicad_pcb, ComponentTester.kicad_sch]
2025-09-21 remove ext. crystal
    [ComponentTester.kicad_pcb, ComponentTester.kicad_sch]
2025-09-21 clean up
    [ComponentTester.kicad_pcb, ComponentTester.kicad_sch]
2025-10-31 some work
    [ComponentTester.kicad_pcb, ComponentTester.kicad_sch, cartridge.FCStd, stencil-CompomentTester.stl, stencil-ComponentTester.FCStd, stencil.FCStd]
2025-11-30 replace ATmega328P with ATmegaPB
    [ComponentTester.kicad_pcb, ComponentTester.kicad_sch]
2026-03-12 hardware changes
    [ComponentTester.kicad_pcb, ComponentTester.kicad_sch]
2026-03-14 fix workflow for test start
    [ArduTester.ino, ComponentTester.ino]
2026-03-15 further fix of communication
    [ArduTester.ino, ComponentTester.ino]
2026-03-16 looks like a fix for the handshake problem
    [ArduTester.ino, ComponentTester.ino]
2026-03-16 A-Button fix
2026-03-16 correction of tps and values
    [ArduTester.ino, ComponentTester.ino]
